marcorispoli/PCB325/DOC/Note Di Progetto.docx

# BUG/NOTE

+ Condensatori al tantalio in lista parti, footprint di condensatori in alluminio case-c;

+ Portare R27, R45,R63 da 3K3 a 4K7 per ottimizzare il range di misura.

# Power Supply

## Ingresso alimentazione

Il circuito di alimentazione in ingresso è un classico schema con filtro EMI e fusibile.

Il connettore di ingresso conduce anche i segnali relativi al Bus di comunicazione, (CAN BUS) con relativo filtraggio e protezione ESD.

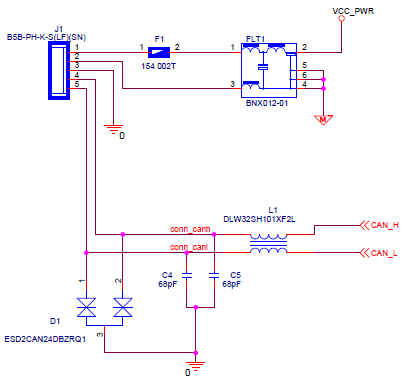
[picture p1: figure]

Il fusibile è impostato a 2A ritardato, sufficiente per il carico massimo richiesto all’alimentazione.

## Ingresso e circuito di hot swap

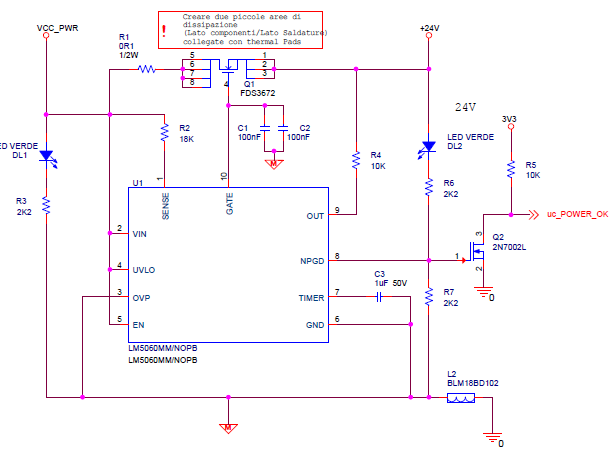
[picture p2: figure]

La tensione di alimentazione di ingresso a 24V viene protetta con un circuito di Hot-swap per consentire la connessione del dispositivo a “caldo”.

Il circuito Attiva l’alimentazione interna con una rampa di circa 300ms e fornisce un segnale di “tensione OK” al microcontrollore quando l’alimentazione è disponibile.

La massa “sporca” o massa motore viene qui unita alla massa di segnale, filtrata con una ferrite per ridurre le spurie condotte dalla sezione del microcontrollore.

### Verifica Circuito Hot-swap

All’accensione si osserva la tensione a +24V in uscita che cresce con una rampa di circa 200ms. Il valore atteso era di circa 300ms, cosa che successivamente potrà essere meglio indagata, ma è sufficiente per lo scopo inteso.

Il segnale uc_Power_OK viene correttamente attivato al termine della rampa.

## Regolatore +12V

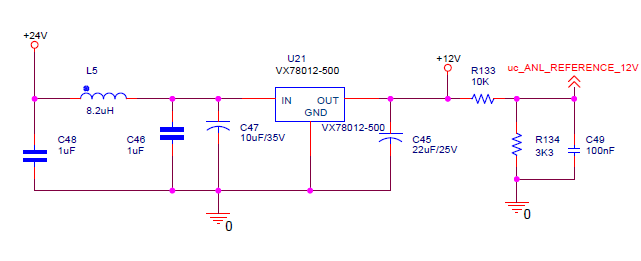
[picture p3: figure]

La scheda utilizza internamente la tensione +12V in diverse sezioni del circuito sia direttamente che come tensione intermedia.

Il regolatore utilizzato, un DC/DC switching, fornisce una tensione stabilizzata con 500mA di corrente massima.

Lo schema proposto è ricavato dal datasheet e sostanzialmente fa uso di una rete LC in ingresso per filtrare le spurie dello stadio switching verso l’alimentazione.

La tensione, opportunamente scalata, viene riletta dal microcontrollore sia come diagnostica sia per calibrare i segnali analogici che da essa dipendono.

### Verifica Circuito Regolatore +12V

La tensione misurata dopo il transitorio di accensione risulta: 12.08V;

Il segnale di controllo verso il microcontrollore risulta: uc_ANL_REFERENCE_12V: 2.98V;

Non sono presenti oscillazioni anomali o disturbi inattesi.

## Regolatore +5V + 3.3V

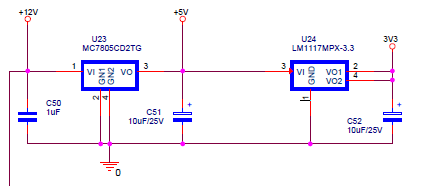
[picture p4: figure]

La scheda utilizza internamente per alimentare diverse parti circuitali una tensione stabilizzata di 5V ottenuta con un regolatore lineare a partire dalla +12V.

Per le alimentazioni e i circuiti di servizio del microcontrollore utilizza una 3.3V ricavata direttamente dalla tensione +5V.

### Verifica tensioni regolate

Tensione +5V: V = 5.048, Rp = 300mV;

Temperatura U23: circa 40°;

Tensione 3V3: V = 3.298, Rp = 90mV;

Temperatura U24: circa 30°;

## Regolatore +5V-EXT

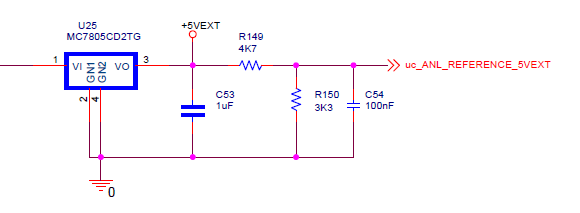
[picture p5: figure]

La scheda utilizza per alimentare parti di dispositivo esterne alla scheda un regolatore lineare da 5V uguale al regolatore per la +V interna.

A scopo diagnostico il valore viene riletto opportunamente scalato dal microcontrollore.

### Verifica Regolatore +5V-EXT

Tensione misurata: V = 5.048, Rp = 300mV;

Temperatura: circa 40°;

uc_ANL_REFERENCE_5VEXT = 2.067, Rp= 200mV

# Controllore

Lo schema utilizza un microcontrollore microchip della serie SAME51J20A.

Il microcontrollore non utilizza oscillatori /quarzi esterni per generare le frequenze di BUS interne.

Lo schema di alimentazione del microcontrollore è ricavato direttamente dal datasheet e fa uso di ferriti beads sulle sezioni di alimentazione per ridurre le EMI condotte.

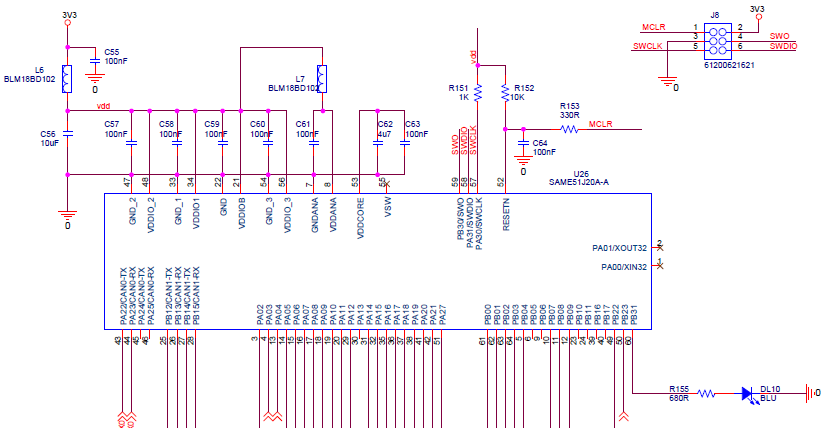
[picture p6: figure]

Il micro viene programmato tramite il connettore J6 con apposito protocollo e programmatore della serie PICKIT-xx compatibile con i controllori SAME.

Il controllore è dotato di LED blu con la funzione di Vitality Led.

## Verifica programmazione

Allo scopo di verificare il corretto funzionamento è stato preparato un firmware di test che permette di attivare il led di vitalità con un periodo di ON-OFF di 2 secondi (1 secondo ogni stato).

La programmazione è avvenuta con successo e la frequenza di oscillazione è quella attesa.

L’alimentazione è rimasta stabile.

Spegnendo e riaccedendo l’alimentazione di ingresso a 24V, il microcontrollore è ripartito correttamente.

# Circuito di controllo del Buzzer

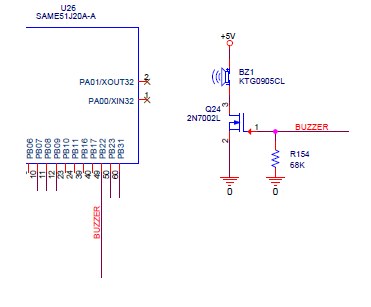
[picture p7: figure]

Il microcontrollore controlla direttamente un Buzzer collegato all’uscita PB22 tramite un Mosfet di segnale.

## Verifica Buzzer

Il firmware di test utilizzato ha generato delle attivazioni ON-OFF con 1 secondo di attivazione per stato.

Il Buzzer ha correttamente eseguito il ciclo di attivazione.

# Circuito di controllo alimentazione motore

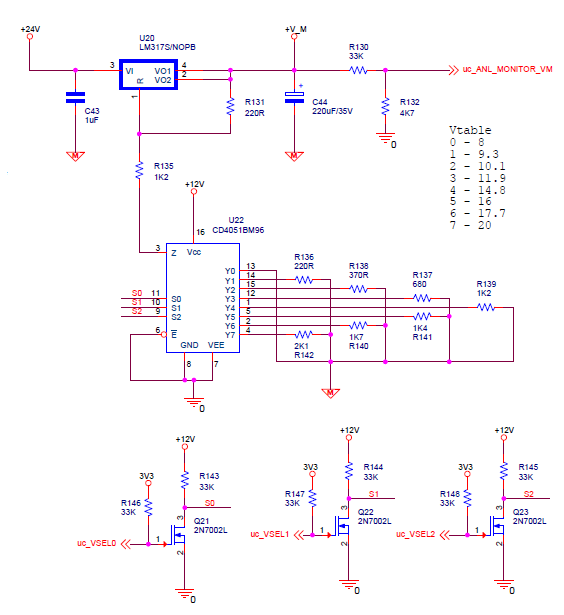
[picture p8: figure]

La scheda utilizza un regolatore lineare controllato digitalmente per generare livelli differenti di alimentazione per il driver motore. Questo consente di regolare la coppia disponibile e la velocità massima del motore durante le fasi di accelerazione corsa e avvicinamento al target di posizionamento.

Il regolatore è un classico LM317 il cui circuito di controllo viene gestito attraverso un CD4051 che assegna 8 possibili resistenze in serie a R135, ottenendo quindi 8 possibili livelli di regolazione della tensione di uscita.

## Verifica della selezione tensione motore

La tabella che segue mostra i livelli attesi in funzione dell’impostazione dei segnali digitali e il valore effettivamente generato dalla scheda:

Vsel2 | Vsel1 | Vsel0 | V - attesa | V - misurata
1 | 1 | 1 | 8 | 9.17
1 | 1 | 0 | 9.3 | 10.3
1 | 0 | 1 | 10.1 | 11.19
1 | 0 | 0 | 11.9 | ???
0 | 1 | 1 | 14.8 | 15.87
0 | 1 | 0 | 16 | 17.2
0 | 0 | 1 | 17.7 | 18.82
0 | 0 | 0 | 20 | 20.51

# Circuito di controllo dei pulsanti di attivazione

La funzione dei pulsanti di attivazione motori è duplice:

+ Attivazione motori per calibrazione posizioni: alla pressione dei pulsanti, i motori si muovono a target predefiniti;

+ Attivazione motori per piccoli steps: alla pressione dei pulsanti, i motori si muovono di piccoli steps predefiniti;

Il circuito di controllo dei pulsanti prevede:

+ una sezione di rilevazione del pulsante premuto che riporta al microcontrollore lo stato di attivazione;

+ una sezione di bypass delle sicurezze di attivazione del motore;

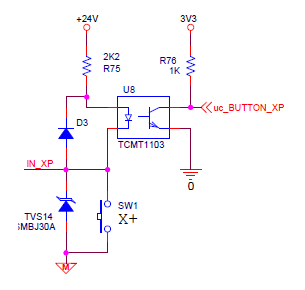
[picture p9: figure]

Per ogni pulsante di attivazione (in figura è riportato il pulsante X+) è prevista una protezione ESD e un opto isolatore. Lo stato di attivazione è attivo Basso.

### Verifica del rilevamento attivazione pulsante

La tabella che segue riporta lo stato delle tensioni rilevate in funzione della pressione del pulsante relativo:

Pulsante | Stato | V - micro
X+ | Off | 3.3
X+ | On | 0.13
X- | Off | 3.3
X- | On | 0.13
Y+ | Off | 3.3
Y+ | On | 0.13
Y- | Off | 3.3
Y- | On | 0.13
Z+ | Off | 3.3
Z+ | On | 0.13
Z- | Off | 3.3
Z- | On | 0.13

Con il firmware di test si è verificato che lo stato di ciascun pulsante sia correttamente letto dal microcontrollore. Il test è stato eseguito con successo.

# Sicurezza motore

Il circuito di sicurezza motore interdice l’attivazione dei motori aprendo con un relè allo stato solido uno dei segnali di pilotaggio dei motori stessi.

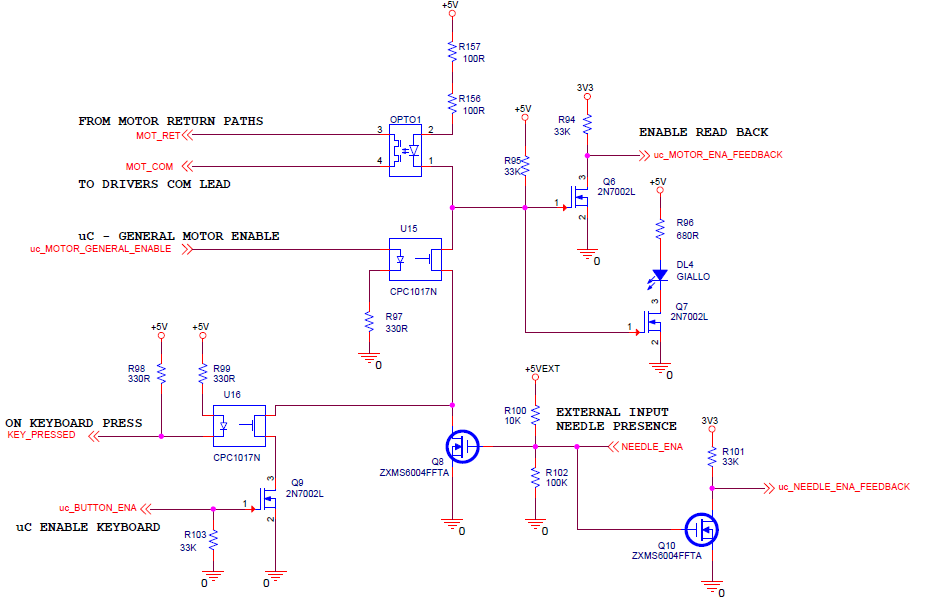
[picture p10: figure]

Nell’immagine precedente che rappresenta lo schema generale di controllo della sicurezza motori si identificano i seguenti segnali:

+ MOT_RET: è il segnale di ritorno dei motori;

+ MOT_COM: è il segnale di ritorno al driver motore;

+ uc_MOTOR_ENA_FEEDBACK: è il segnale (attivo alto) che indica al microcontrollore lo stato di attivazione del relè di sicurezza;

+ uc_MOTOR_GENERAL_ENABLE: è il segnale (attivo alto) di abilitazione generale del relè allo stato solido;

+ uc_BUTTON_ENA: è il segnale (attivo alto) di abilitazione del bypass da pulsanti manuali;

+ KEY_PRESSED: è il segnale (attivo basso) di pressione di almeno un pulsante manuale;

+ NEEDLE_ENA: è il segnale (attivo alto) di assenza del NEEDLE;

+ uc_NEEDLE_ENA_FEEDBACK : è il segnale (attivo alto) dello stato di assenza del needle per il microcontrollore;

Il led DL4 indica che la protezione è attiva (motore disabilitato)

## Abilitazione generale

Una linea digitale del microcontrollore (uc_MOTOR_GENERAL_ENABLE) ha la funzione di abilitazione generale: se tale linea è disattiva il relè è sempre aperto:

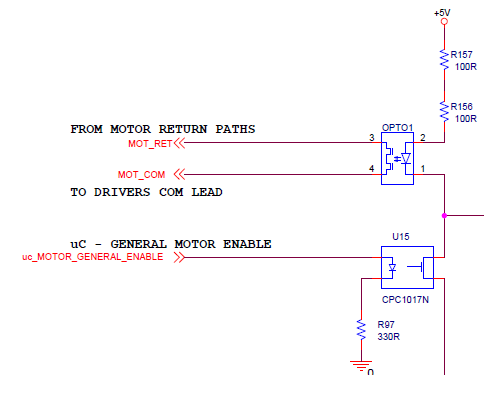
[picture p11: figure]

Come si vede dall’immagine precedente, se il segnale è spento il circuito di pilotaggio del relè viene interdetto.

## Abilitazione da Pulsanti manuali

La scheda deve consentire l’abilitazione all’attivazione dei motori se uno dei pulsanti viene premuto.

La scheda utilizza anche una linea digitale del microcontrollore per abilitare questa funzione.

Quando l’abilitazione è attiva e uno dei pulsanti viene premuto, il relè allo stato solido si attiva.

Come si osserva dalla figura seguente, la linea marrone indica il percorso circuitale di attivazione del relè allo stato solido:

- Abilitazione Generale ((uc_MOTOR_GENERAL_ENABLE);
- KEY_PRESSED = 0.7V;
- Abilitazione bypass da pulsanti (uc_BUTTON_ENA);

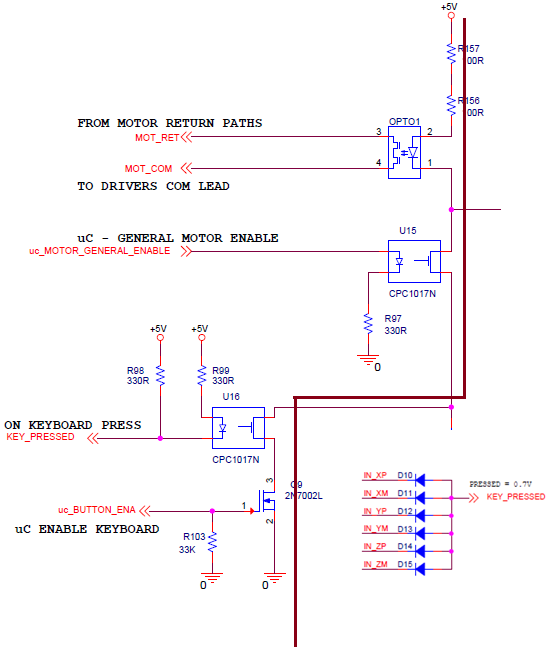
[picture p12: figure]

## Abilitazione da assenza NEEDLE (NEEDLE_ENA)

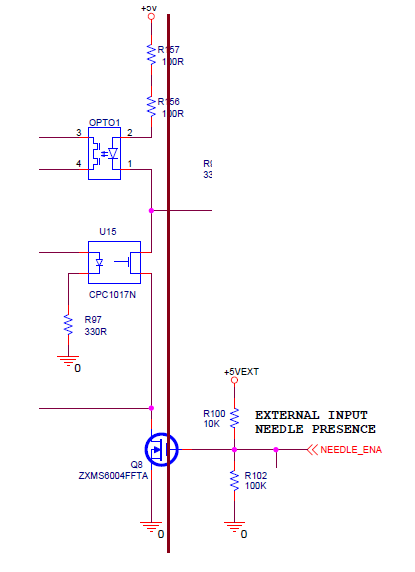
[picture p13: figure]

Come si può osservare dall’immagine precedente, se il segnale proveniente dal sensore di presenza NEEDLE dovesse essere cortocircuitato a massa (needle presente), il mosfet Q8 si apre aprendo anche il relè di sicurezza (si intende senza che i pulsanti manuali siano attivi).

Se invece il needle non è presente (segnale aperto) oppure l’asse Y disconnesso, allora il mosfet chiude il circuito di pilotaggio del relè che risulterà pertanto chiuso (abilitando quindi l’attivazione dei motori).

## Verifica circuiti di sicurezza

### Verifica segnale di abilitazione generale

+ Verificato segnale uc_MOTOR_GENERAL_ENABLE coon micocontrollore;

### Verifica segnale NEEDLE_ENA e feedback

+ Contatto ZIF con Q8 = OK;

+ con NEEDLE_ENA aperto, tensione sulla base di Q8 = 3.3V corretta.

- NOTA: Q8 e Q10 hanno insieme una resistenza di gate (parallelo tra le due) pari a 14K. La tensione di soglia è al massimo 1.5V quindi la polarizzazione a vuoto è sufficiente. Quando l’asse Y è connesso, una resistenza di pullup di 1K aumenterà ulteriormente il livello di polarizzazione.

+ Circuito di Feedback microcontroller OK;

Sebbene la tensione su Q8 sia anomala, tutttavia il circuito funziona.

### Verifica bypass da pulsanti manuali

+ KEY_PRESSED: controllato con tutti i pulsanti, passa da +5V a 0.7V come atteso.

+ uc_BUTTON_ENA: testato con attivazione da microcontrollore;

### Verifica Tabella di Attivazione

General Enable | Key Enable | Key Pressed | NEEDLE_ENA | Power Switch | Motor Ena Feedback | DL4 | Verify
ON | ON | ON/OFF | GND | ON/OFF | ON/OFF | OFF/ON | OK
X | OFF | X | GND | OFF | OFF | ON | OK
OFF | X | X | X | OFF | OFF | ON | OK
ON | X | X | HZ | ON | ON | OFF | OK

# Drivers Motori

La scheda utilizza due drivers per controllare 3 motori brush con schema a doppio ponte H in parallelo.

Ciascun driver è caratterizzato dai seguenti segnali di controllo:

+ ENABLE-A: segnale di abilitazione canale A del driver. Se disabilitato il canale mette le uscite in alta impedenza;

+ ENABLE-B: segnale di abilitazione canale B del driver. Se disabilitato il canale mette le uscite in alta impedenza;

+In1-A, In2-A: imposta la modalità del ponte (direzione) per il canale A;

+In1-B, In2-B: imposta la modalità del ponte (direzione) per il canale B;

Il driver viene alimentato con la +V-M che assume valori da 10 a 20V in funzione della codifica digitale che il microcontrollore fornisce al regolatore.

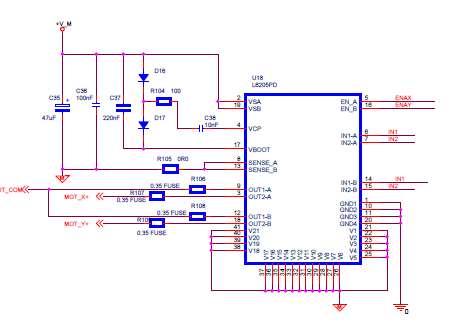
[picture p14: figure]

Le uscite sono tutte protette da PTC che limitano correnti di CC.

La codifica dei segnali di controllo viene ottenuta attraverso un decoder digitale:

i mosfet servono per adattare i segnali digitali del microcontrollore a 3.3V con quelli dei drivers a 5V.

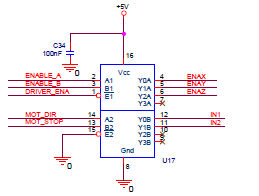
[picture p15: figure]
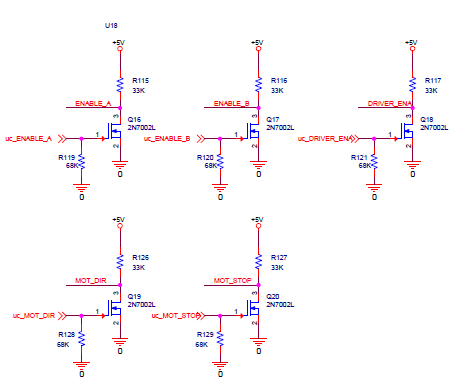
[picture p16: figure]

Tabella di abilitazione driver motore

uc_DRIVER_ENA | uc_ENABLE_B | uc_ENABLE_A | MOTOR-X-ENA (DL5) | MOTOR-Y-ENA (DL6) | MOTOR-Z-ENA (DL7)
0 | X | X | 0 (OFF) | 0 (OFF) | 0 (OFF)
1 | 0 | 0 | 0 (OFF) | 0 (OFF) | 0 (OFF)
1 | 0 | 1 | 0 (OFF) | 0 (OFF) | 1 (ON)
1 | 1 | 0 | 0 (OFF) | 1 (ON) | 0 (OFF)
1 | 1 | 1 | 1 (ON) | 0 (OFF) | 0 (OFF)

uc_MOTOR_STOP | uc_MOTOR_DIR | In1 (DL8) | In2 (DL9) | Motor Output state
0 | 0 | 0 | 0 | SHORT-GND
0 | 1 | 0 | 0 | SHORT-GND
1 | 0 | 0 | 1 | GND - VM
1 | 1 | 1 | 0 | VM – GND

## Verifica Drivers Motori

### Verifica abilitazione motori

Con un firmware di test vengono stimolati i segnali di controllo.

Con il tester vengono misurate le tensioni sui pin di controllo del driver e l’effettivo stato di attivazione dei leds:

uc_DRIVER_ENA | uc_ENABLE_B | uc_ENABLE_A | V DRIVER-ENA | V ENABLE-B | V ENABLE-A
1 | - | - | 0 | 4.8 | 4.8
- | 1 | - | 4.8 | 0 | 4.8
- | - | 1 | 4.8 | 4.8 | 0

uc_DRIVER_ENA | uc_ENABLE_B | uc_ENABLE_A | V ENAX (DL5) | V ENAY (DL6) | V ENAZ (DL7)
0 | X | X | 0 (OFF) | 0 (OFF) | 0 (OFF)
1 | 0 | 0 | 0 (OFF) | 0 (OFF) | 0 (OFF)
1 | 0 | 1 | 0 (OFF) | 0 (OFF) | 5V (ON)
1 | 1 | 0 | 0 (OFF) | 5V (ON) | 0 (OFF)
1 | 1 | 1 | 5V (ON) | 0 (OFF) | 0 (OFF)

### Verifica tabella attivazione motori

Con un firmware di test vengono stimolati i segnali di controllo.

Con il tester vengono misurate le tensioni sui pin di controllo del driver e l’effettivo stato di attivazione dei leds:

uc_MOT_STOP | uc_MOT_DIR | V MOTOR-STOP | V MOTOR-DIR
1 | - | 0 | 4.8
- | 1 | 4.8 | 0

uc_MOT_STOP | uc_MOT_DIR | V-IN1 (DL8) | V-IN2 (DL9)
0 | 0 | 0 (OFF) | 0 (OFF)
0 | 1 | 0 (OFF) | 0 (OFF)
1 | 0 | 0 (OFF) | 5 (ON)
1 | 1 | 5 (ON) | 0 (OFF)

### Verifica uscite motori

Con firmware di test si imposta la scheda come segue:

- Tensione dell’alimentazione motore pari a circa 10V;
- Abilitazione generale attivazione motori;
- Segnale NEEDLE_ENA aperto;

Disabilitazione di tutti i motori:

- uc_DRIVER_ENA = OFF;

verificare che tutte le uscite motori siano in alta impedenza;

Abilitazione motori e verifica uscite:

- uc_DRIVER_ENA = ON;

Motor X

uc_ENABLE_B | uc_ENABLE_A | uc_MOTOR_STOP | uc_MOTOR_DIR | X+ | X-COM
1 | 1 | 0 | X | GND | GND
1 | 1 | 1 | 0 | GND | VM
1 | 1 | 1 | 1 | VM | GND

Motor Y

uc_ENABLE_B | uc_ENABLE_A | uc_MOTOR_STOP | uc_MOTOR_DIR | Y+ | Y-COM
1 | 0 | 0 | X | GND | GND
1 | 0 | 1 | 0 | GND | VM
1 | 0 | 1 | | VM | GND

Motor Z

uc_ENABLE_B | uc_ENABLE_A | uc_MOTOR_STOP | uc_MOTOR_DIR | Y+ | Y-COM
0 | 1 | 0 | X | GND | GND
0 | 1 | 1 | 0 | GND | VM
0 | 1 | 1 | | VM | GND

# Power LED

La scheda controlla un Led di potenza con circuito switching che regola la corrente erogata al led ad esso connesso:

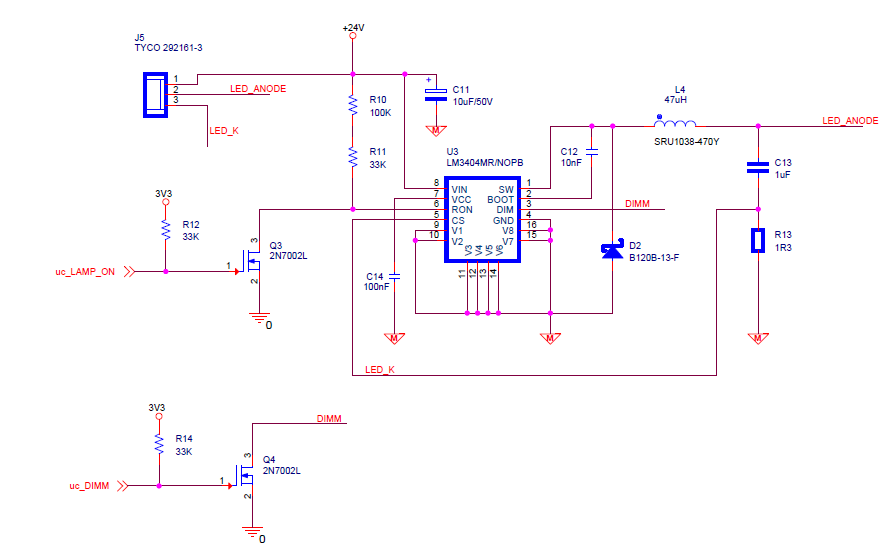
[picture p17: figure]

Il circuito prevede i seguenti segnali di controllo:

- uc_LAMP_ON: attivo basso, abilita l’attivazione della LED;
- uc_DIMM: controlla in PWM la corrente di uscita del led;

uc_LAMP_ON | uc_DIMM | LUCE
1 | X | OFF
X | 1 | OFF
0 | 0 | 100% ON
0 | 1 | 0% ON

La corrente RMS sul led attesa è circa di 200mA quando DIMM è pilotato al 100%.

## Verifica funzionamento e prestazioni

La massima corrente misurata con DIMM = 0 (100%) risulta pari a 190mA;

Con il firmware di test si realizza un PWM che con un periodo di 3.8ms imposta il segnale uc_DIMM con un duty cycle da 0 a 100%: la corrente misurata passa da pochi mA alla massima corrente seguendo l’andamento del segnale uc_DIMM.

# Posizione Assi X,Y,Z

La gestione della posizione per ogni asse avviene secondo lo schema della figura seguente:

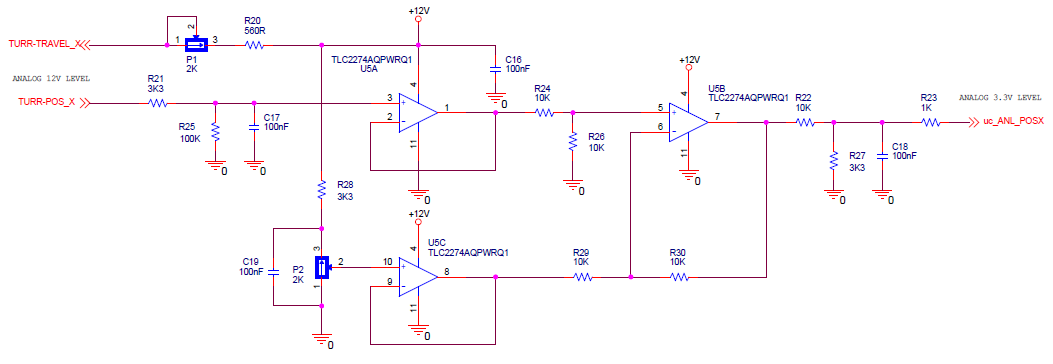
[picture p18: figure]

La dinamica della corsa viene regolata con il potenziometro P1 da 2K che limita il massimo valore di tensione sul potenziometro da 5K usato per rilevare la posizione.

La posizione di zero viene impostata con il potenziometro P2 la cui tensione viene detratta dalla tensione di ingresso del potenziometro di misura.

La formula per ottenere il valore di tensione in uscita è la seguente:

Vout = (((12 * 5 * psens / (5 + p1*2 + 0.56)) * 0.968 ) – p2 * 12 * 2 / 5.3) * 0.248;

Nota: 0.248 è ottenuto con a partizione in uscita 3K3 su 10K. Questa non è ottimale poichè al massimo si ottiene una tensione di 2.54V invece che 3.3.

Meglio portare a 4k7 la resistenza bassa.

## Verifica Posizione

Le misure seguenti sono ottenute con 3K3.

Impostando Ps=1, P1=0,P2=0 si dovrebbe avere 2.54 (valore massimo ottenibile). Misurato 2.54 ;

Modificando i sensori l’uscita cambia in maniera attesa.

# RICONOSCIMENO ANALOGICO NEEDLE_ID

Il riconoscimento del tipo di Ago avviene tramite segnale analogico ottenuto come partitore tra una resistenza di 5K e una resistenza “remota” secondo lo schema seguente:

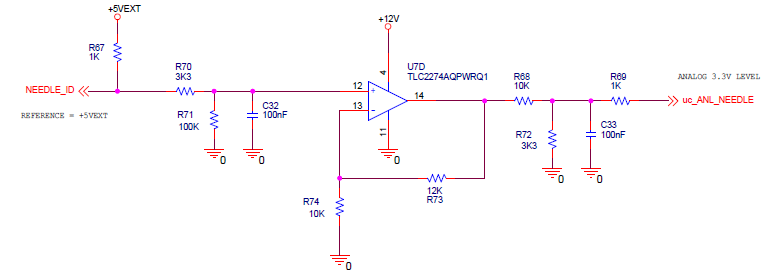
[picture p19: figure]

Fattore di conversione teorico: 0.5233;

## Verifica e performance

Valore di tensione V(uc_ANL_NEEDLE) con NEEDLE_ID aperto: 2.74V (atteso = 2.616);

Valore letto con Vin = 2.61V (resistenza circa 1K): 1.44V

# RICONOSCIMENO ANALOGICO XSCROLL

Il riconoscimento della traslazione dell’asse X avviene tramite segnale analogico ottenuto come partitore tra resistenze remote su alimentazione 5VEXT.

Il segnale viene bufferizzato, filtrato e convertito su range 3.3V

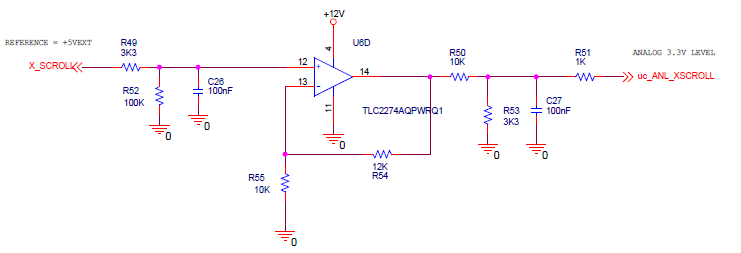
[picture p20: figure]

Fattore di conversione teorico: 0.528;

## Verifica e performance

…

# RICONOSCIMENO POSIZIONE SCIVOLO

Il riconoscimento della posizione dello scivolo sul cuneo viene ottenuto come partizione della tensione 12V (TURR-TRACEL_SH) e un potenziometro da 5K lineare.

Il segnale viene bufferizzato, filtrato e convertito in range 0-3.3V

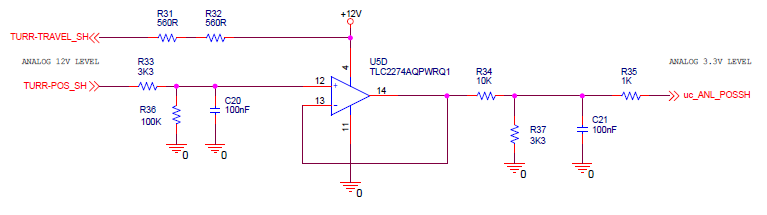
[picture p21: figure]

Formula di conversione:

Vout = 12 * (10 * psh / (10 *psh + 1.12)) * (100 /103.3) * (3.3/13.3);

con psh = [0:1];

## Verifica e performance

…
