marcorispoli/PCB325/DOC/PD 7.3.a A2 Mod 154_Z190_punto 4.9.2_PCB-23-325-0.pdf

All. 2 MODULO VERBALE Riunione di Progetto | PD 7.3.a A2
Procedura Documentata | Mod 154 | Rev. 1
“PROGETTAZIONE E SVILUPPO” | Pag. 1/ 1
PD 7.3.a A2 Mod 154_Z190_punto 4.9.5 | Pagina 1 di 1

Documento di proprietà privata - Riproduzione vietata

No. PROGETTO
001 / 2018

No. COMMESSA Z190

NOME APPARATO

Top of The Line DBT
DiMoBIS

VERIFICA
DELLA PROGETTAZIONE
(VERIFICA DEGLI ARTEFATTI)

### 4.9.2 Verifica degli artefatti elettronici - Verification of electronic artifacts

VERIFICA PROGETTO SCHEDA PCB\23-325-0
PCB\23-325-0 VERIFICATION

Introduzione.
Come da procedura le parti elettroniche dell’apparecchio sono soggette a verifica. Il presente verbale documenta la verifica sul prototipo della scheda PCB\23-325-0.

Il report è disponibile nell’allegato TRP0XX_00-Z190 PCB\23-325-0 Verification.

L’esito è POSITIVO.

As per procedure, the electronic parts of the appliance are subject to verification. This report documents the verification of the prototype PCB 23-325-0.

The report is available in the TRP0XX_00-Z190 PCB\23-325-0 Verification annex.

The result is POSITIVE.

Allegati /Attachment:

### 1. TRP018_00-Z190 PCB\23-325-0 VERIFICATION 2. CPV verification PCB\23-325-0-electronics_r00

Pomezia, 20.10.2024
FUNZIONI | NOMI PARTECIPANTI | FIRMA
hdR&D | Giovanni B. Peretta
hdPROMA | Federico Rinaldi
hdUFTEC | Gloria Pesce Delfino
rePROGEL | Marco Rispoli
