marcorispoli/PCB325/LAYOUT/Layout farcito.png

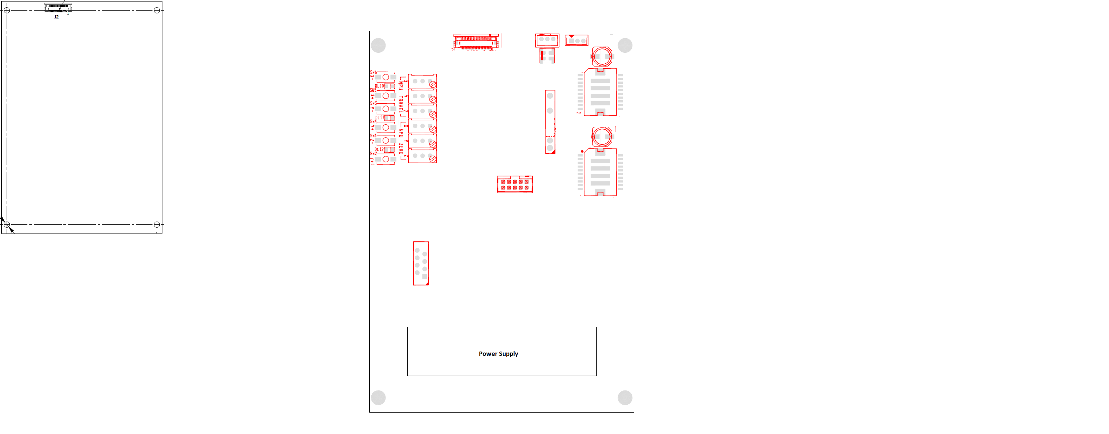
LAYOUT/Layout farcito.png
