marcorispoli/PCB325/(list of files, cad)

Other CAD files:
ESECUTIVI/PF23-325-0.dwg
LAYOUT/A0724-001-A - PCB-23-325-0 - SCHEDA CONTROLLER BIOPSIA LATERALE 1.DXF
ESECUTIVI/PM23-325-0.dwg
LAYOUT/23-325-0.dwg
ESECUTIVI/23-325-0.dwg
