marcorispoli/PCB325/DOC/CPV Check piano di verifica _r00.pdf

Procedura Documentata | PD 7.3-a
“PROGETTAZIONE E SVILUPPO”
Check piano di verifica | CPV Rev. 00

DISPOSITIVO MEDICO: Z190 - DiMoBIS (CYBELE) pCB/23-325-0

ASSEGNAZIONE NUMERO DI PROGETTO: 001 / 2018

TIPO DI VERIFICA | Descrizione funzionale oppure requisito (Rif. Allegato) | Descrizione metodo (Rif. Allegato) | ESITO POSITIVO | ESITO NEGATIVO
Elettronica x Meccanica □ Firmware □ Software □ | TRP0XX_00-Z190 PCB\23-325-0 VERIFICATION | TRP018_00-Z190 PCB\23-325-0 VERIFICATION | V

Elettronica □ Meccanica □ Firmware □ Software □

Elettronica □ Meccanica □ Firmware □ Software □

Elettronica □ Meccanica □ Firmware □ Software □

Elettronica □ Meccanica □ Firmware □ Software □

Elettronica □ Meccanica □ Firmware □ Software □

Elettronica □ Meccanica □ Firmware □ Software □

Firma e data del personale che ha effettuato la verifica: | Firma e data hdRD:

Marco Rispoli Giovanni Battista Peretta Gloria Pesce Delfino
