marcorispoli/PCB325/ORCAD/CONNESSIONI-DB9.pdf

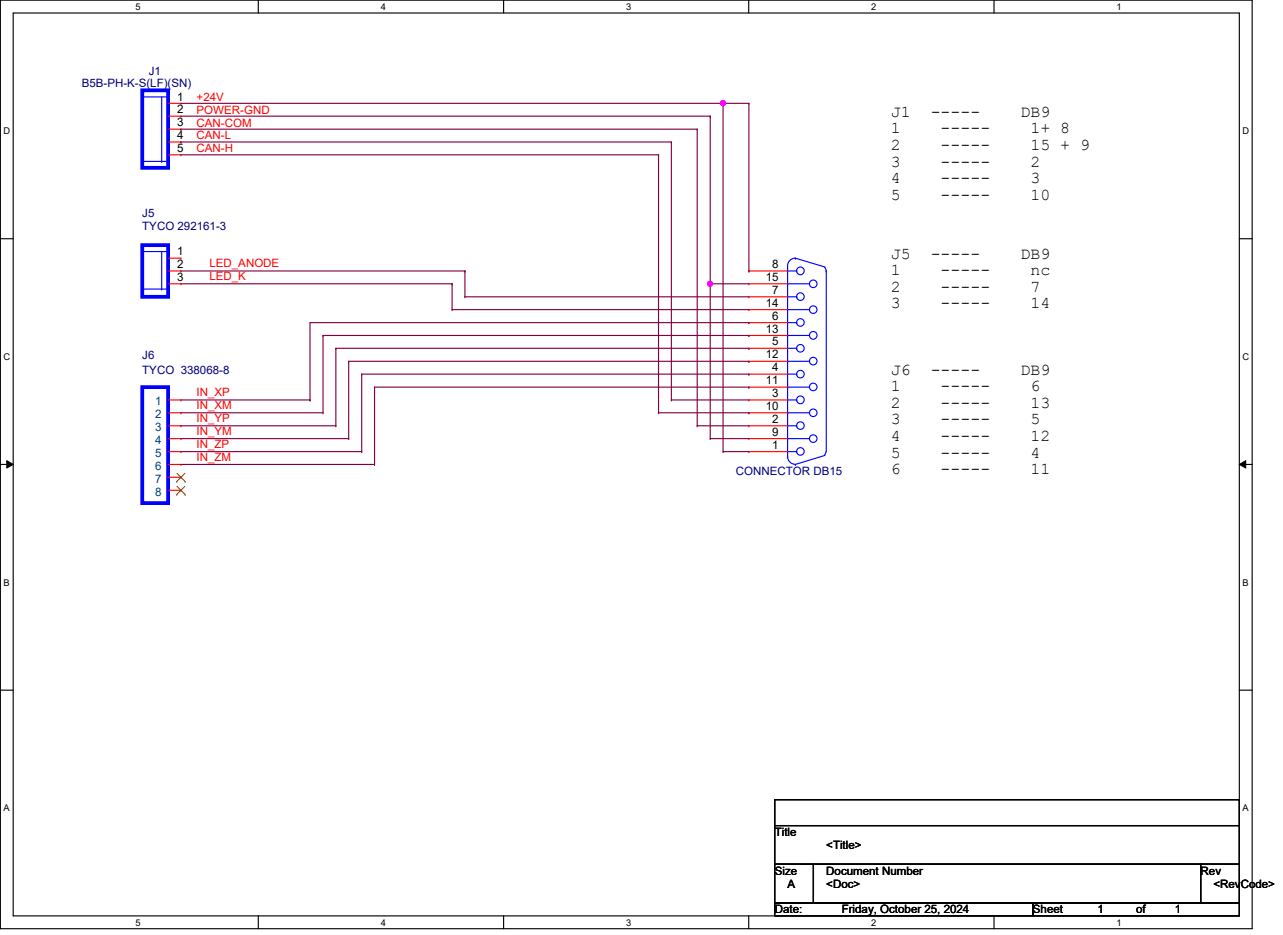
[picture p23: page 1]
Title; Size; Document Number; Rev; Date:; Sheet; <Doc>; <RevCode>; <Title>; 1 1Friday, October 25, 2024; J5 TYCO 292161-3; J6 TYCO 338068-8; CONNECTOR DB15; +24V POWER-GND CAN-COM CAN-L CAN-H; LED_ANODE LED_K
