marcorispoli/PCB325/ORCAD/SE23-325-0.pdf

0
0

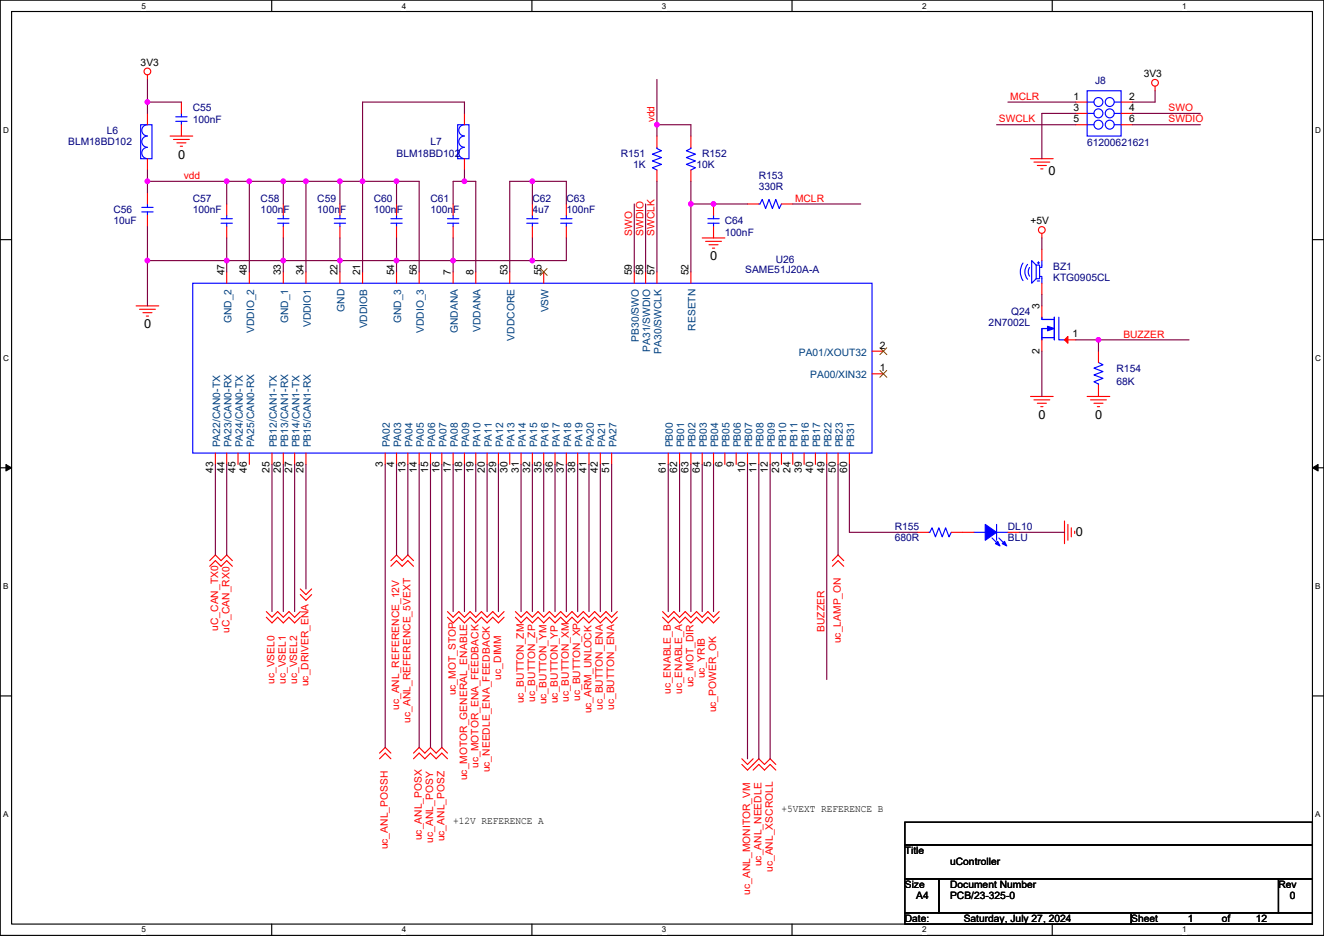
[picture p24: page 1]

Size A4 | Document Number PCB/23-325-0 | Rev 0

Date: Saturday, July 27, 2024 | Sheet 1 of 12

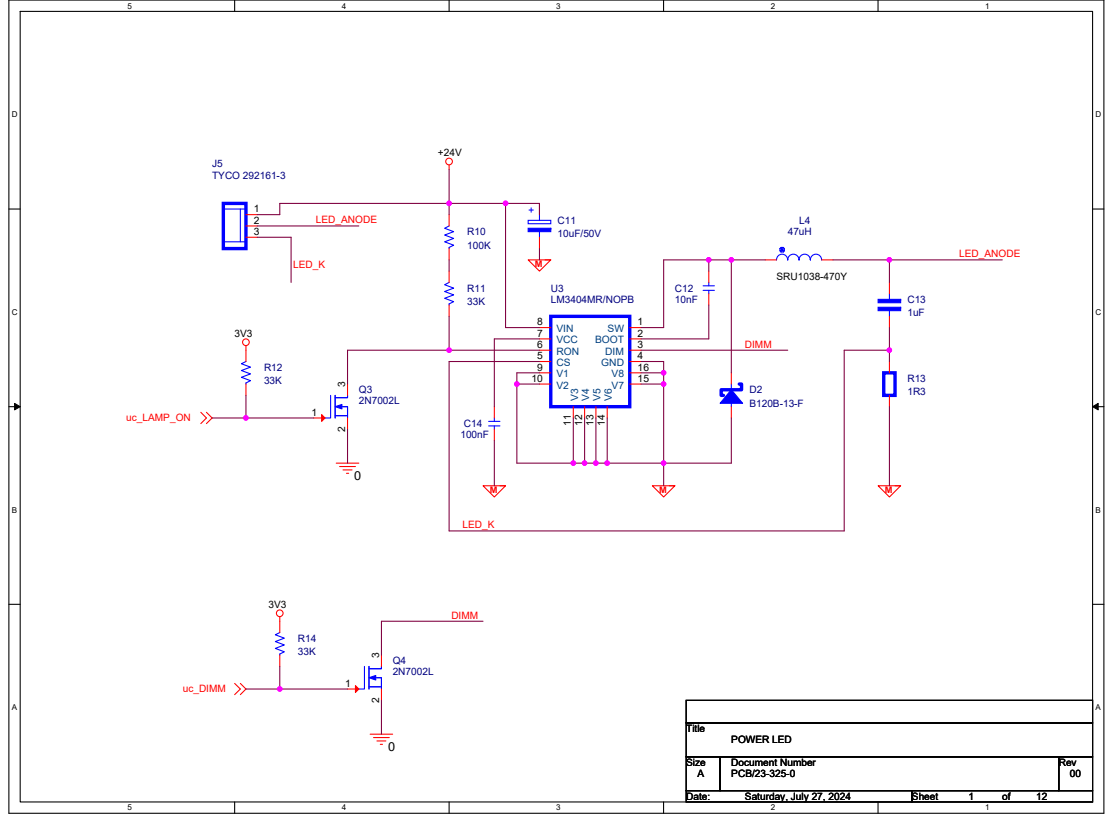
[picture p25: page 2]

## Vtable

0 - 8

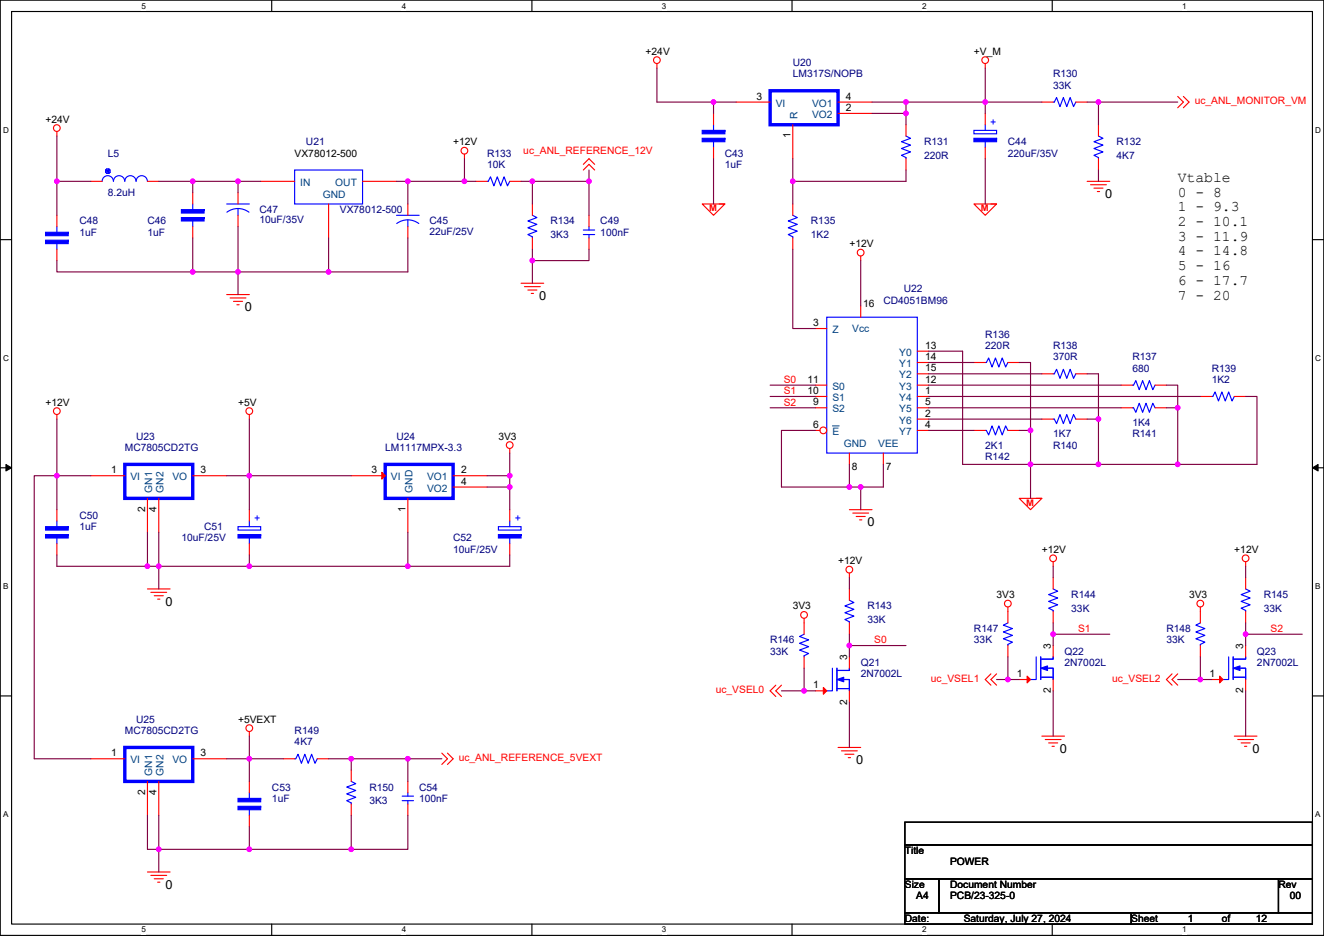
[picture p26: page 3]

0

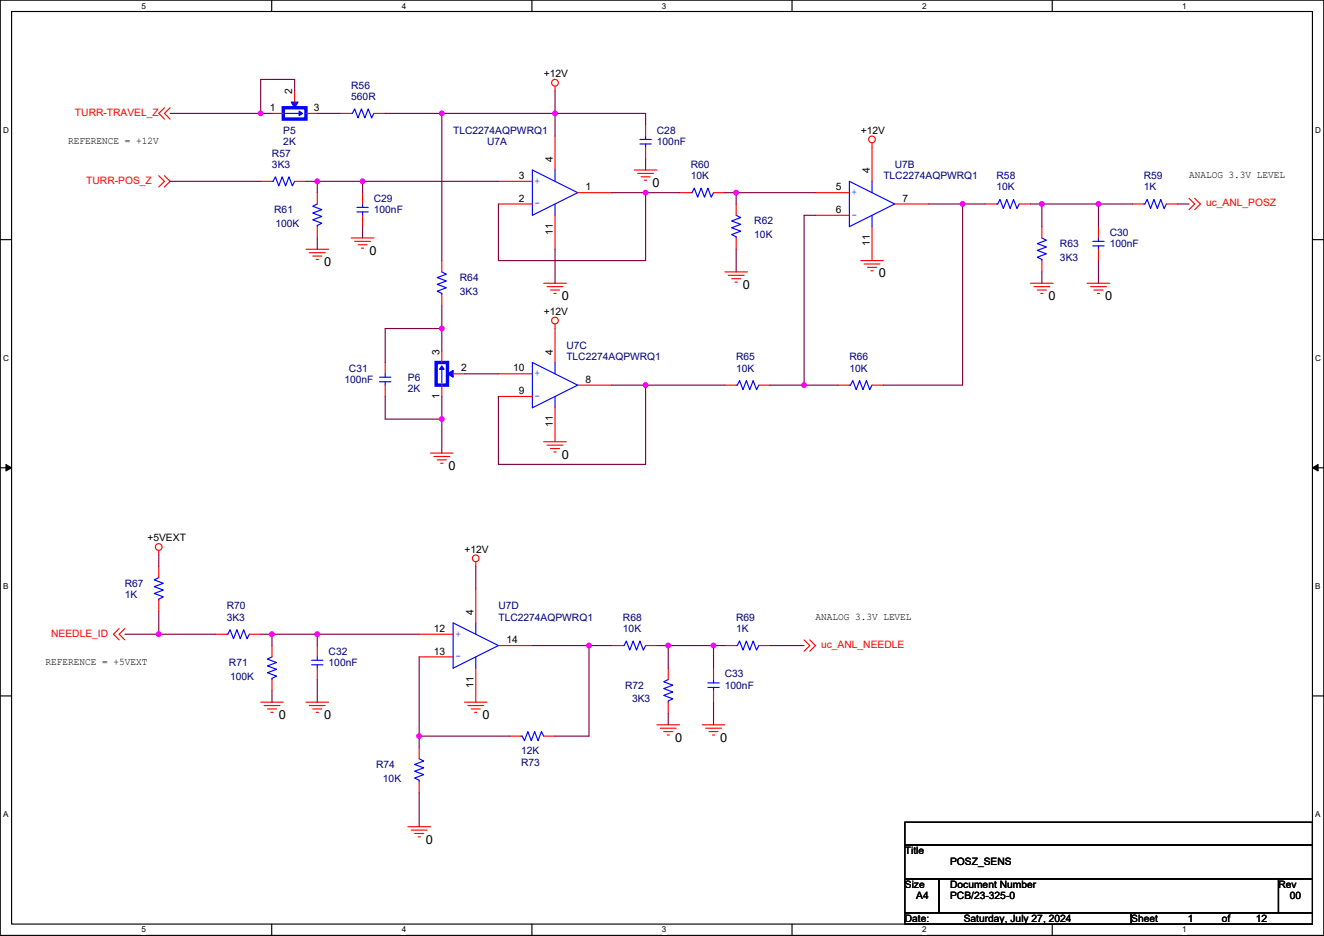
[picture p27: page 4]

0

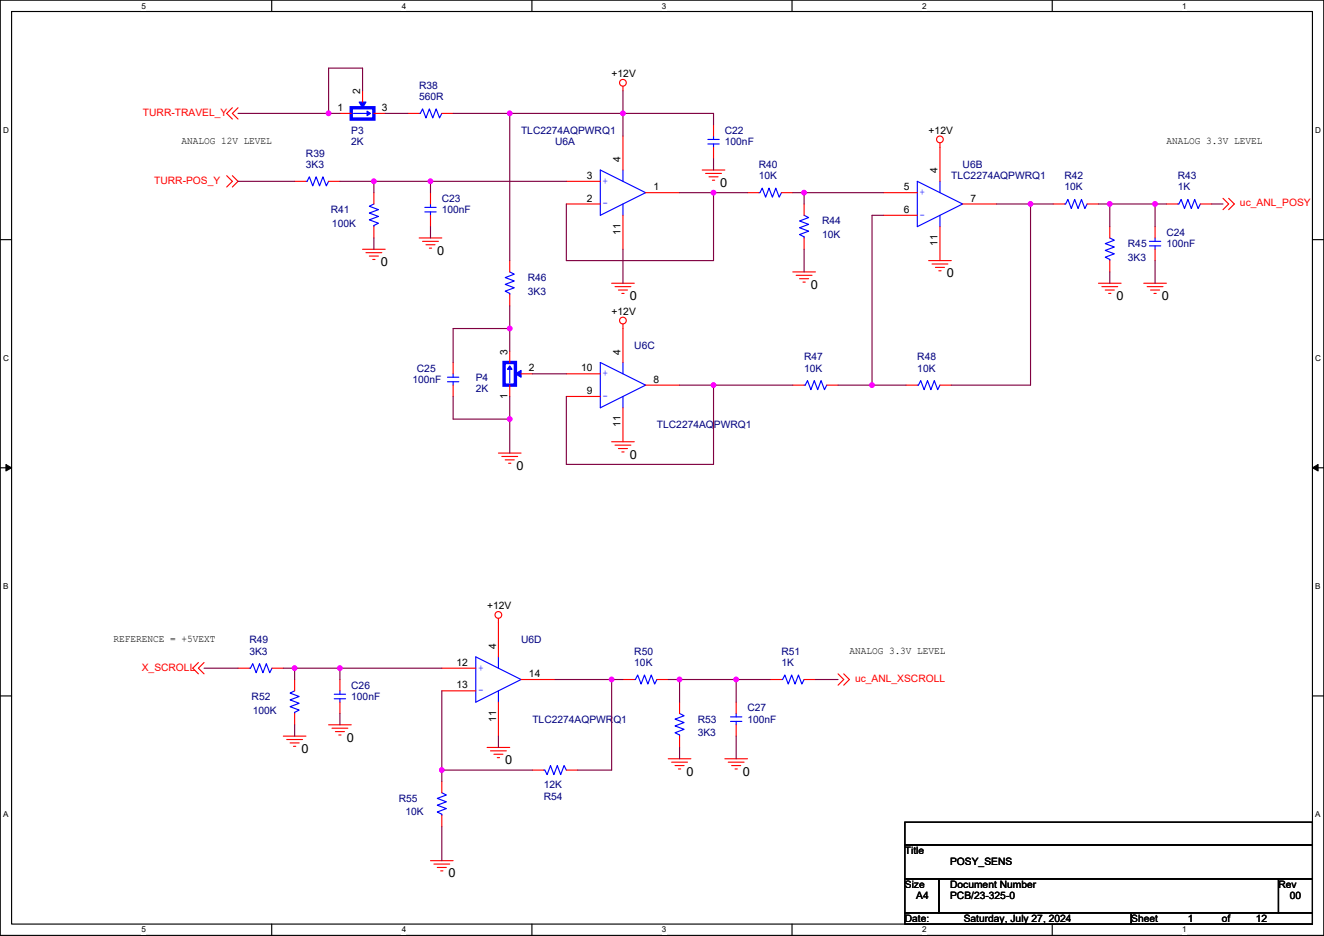
[picture p28: page 5]

0

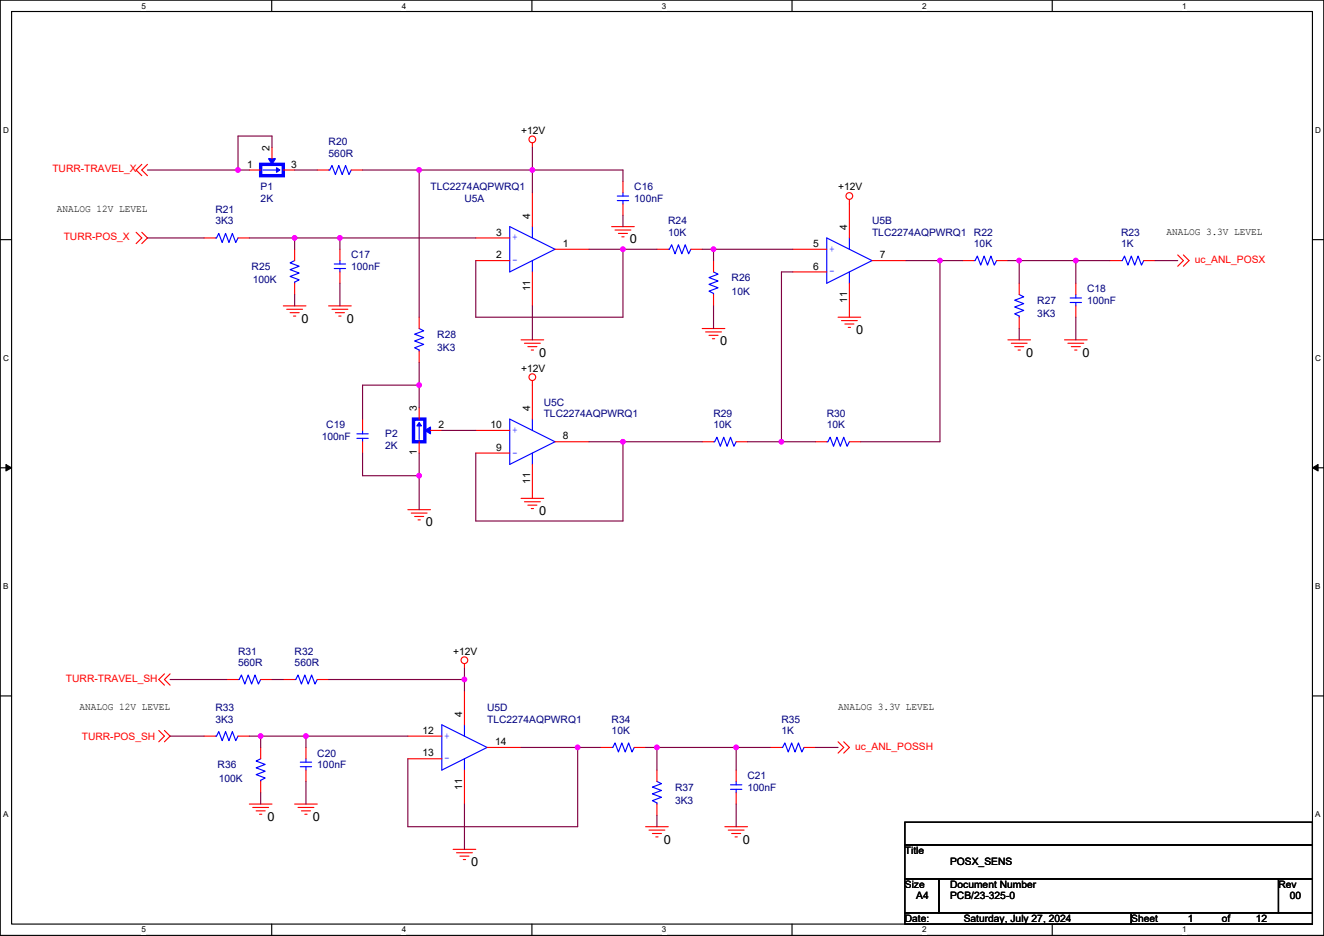
[picture p29: page 6]

0

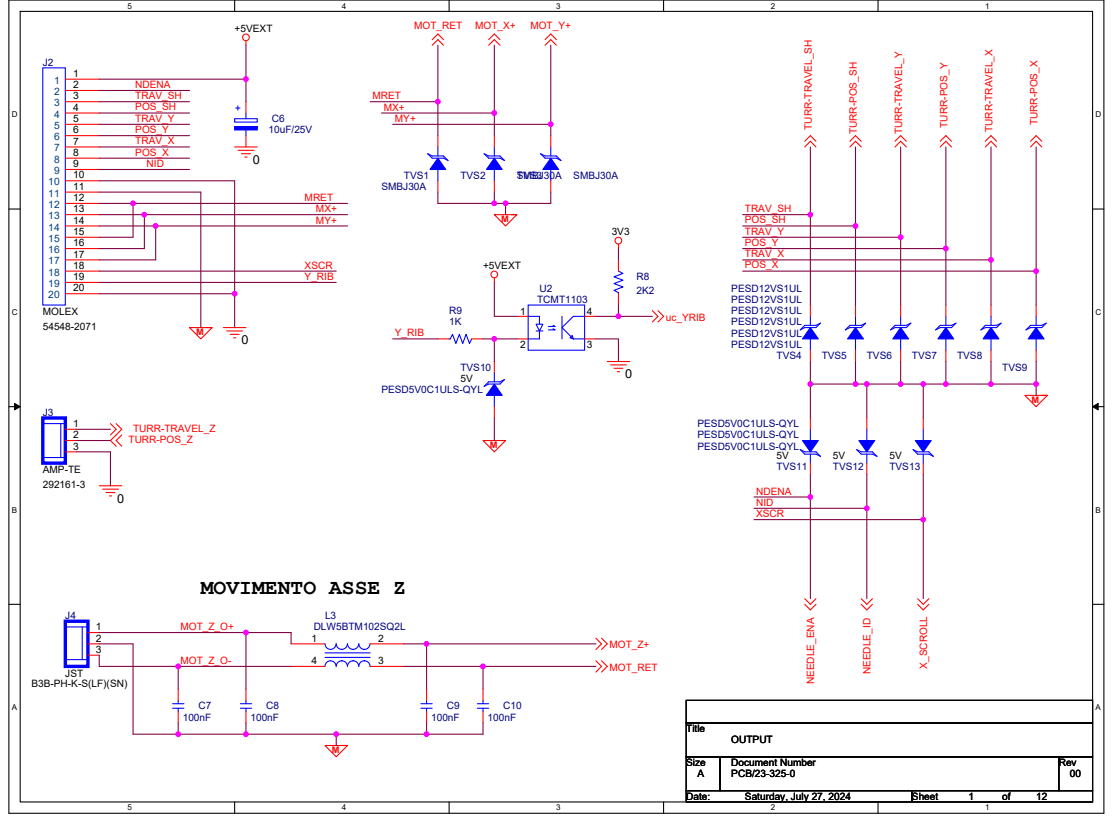
[picture p30: page 7]

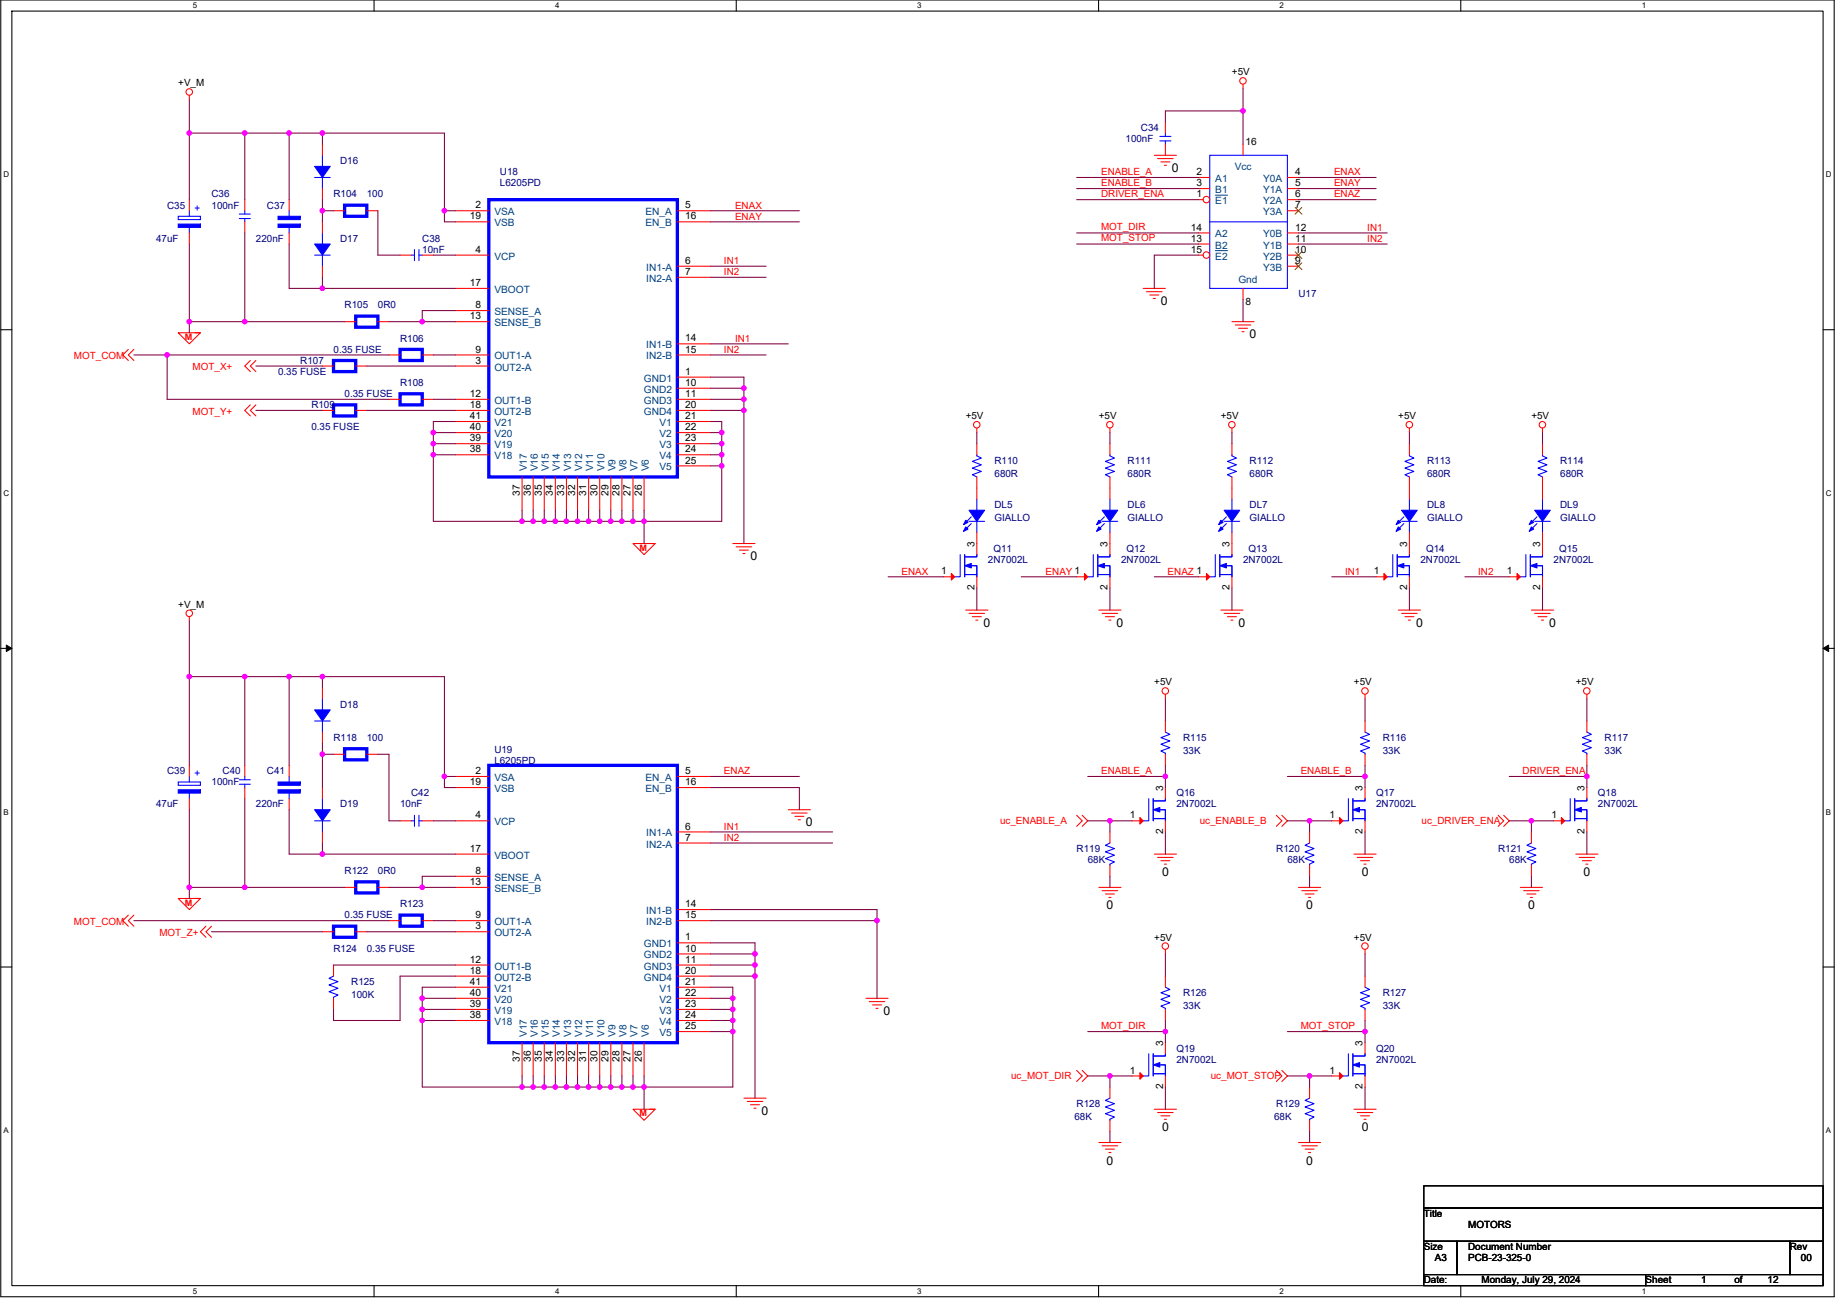
[picture p31: page 8]

PCB-23-325-0 PCB-23-325-0 PCB-23-325-0 | 00 00 00

Monday, July 29, 2024 Monday, July 29, 2024 Monday, July 29, 2024 | 1 1 1 12 12 12

# ENABLE READ BACK

# FROM MOTOR RETURN PATHS

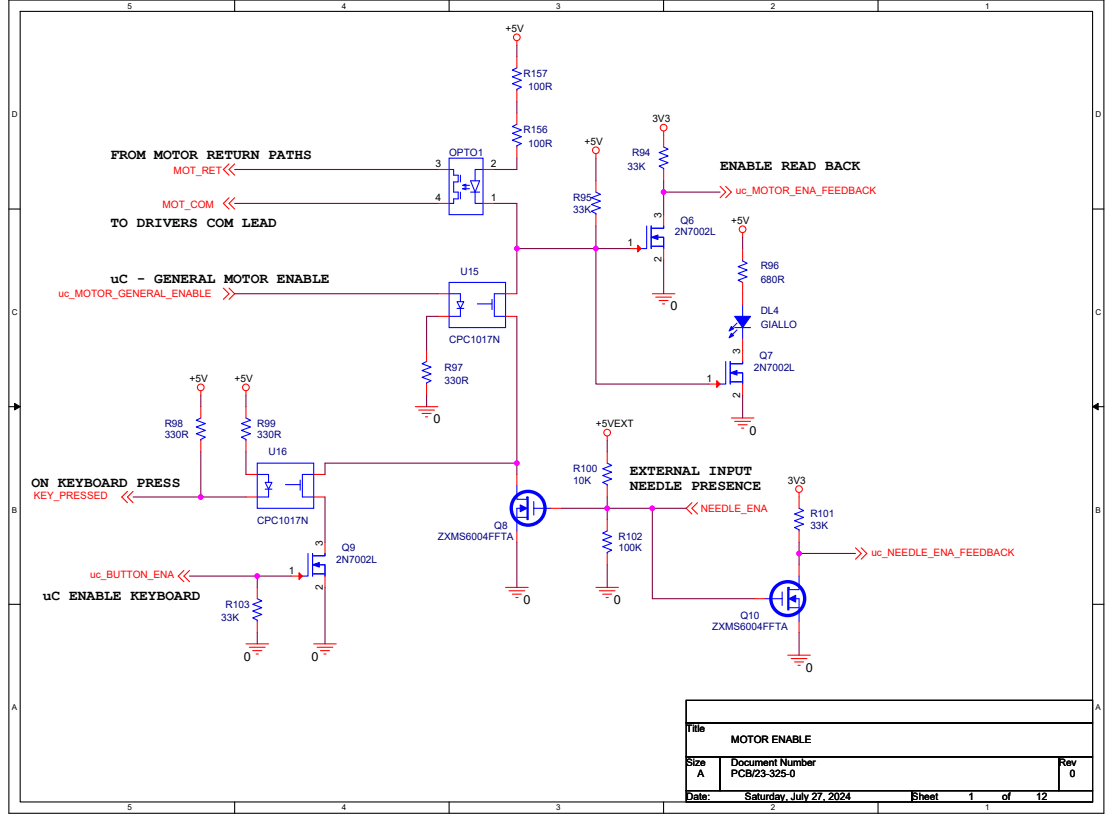
[picture p32: page 9]

TO DRIVERS COM LEAD

uC - GENERAL MOTOR ENABLE

5 | 4 | 3 | 2 | 1

D

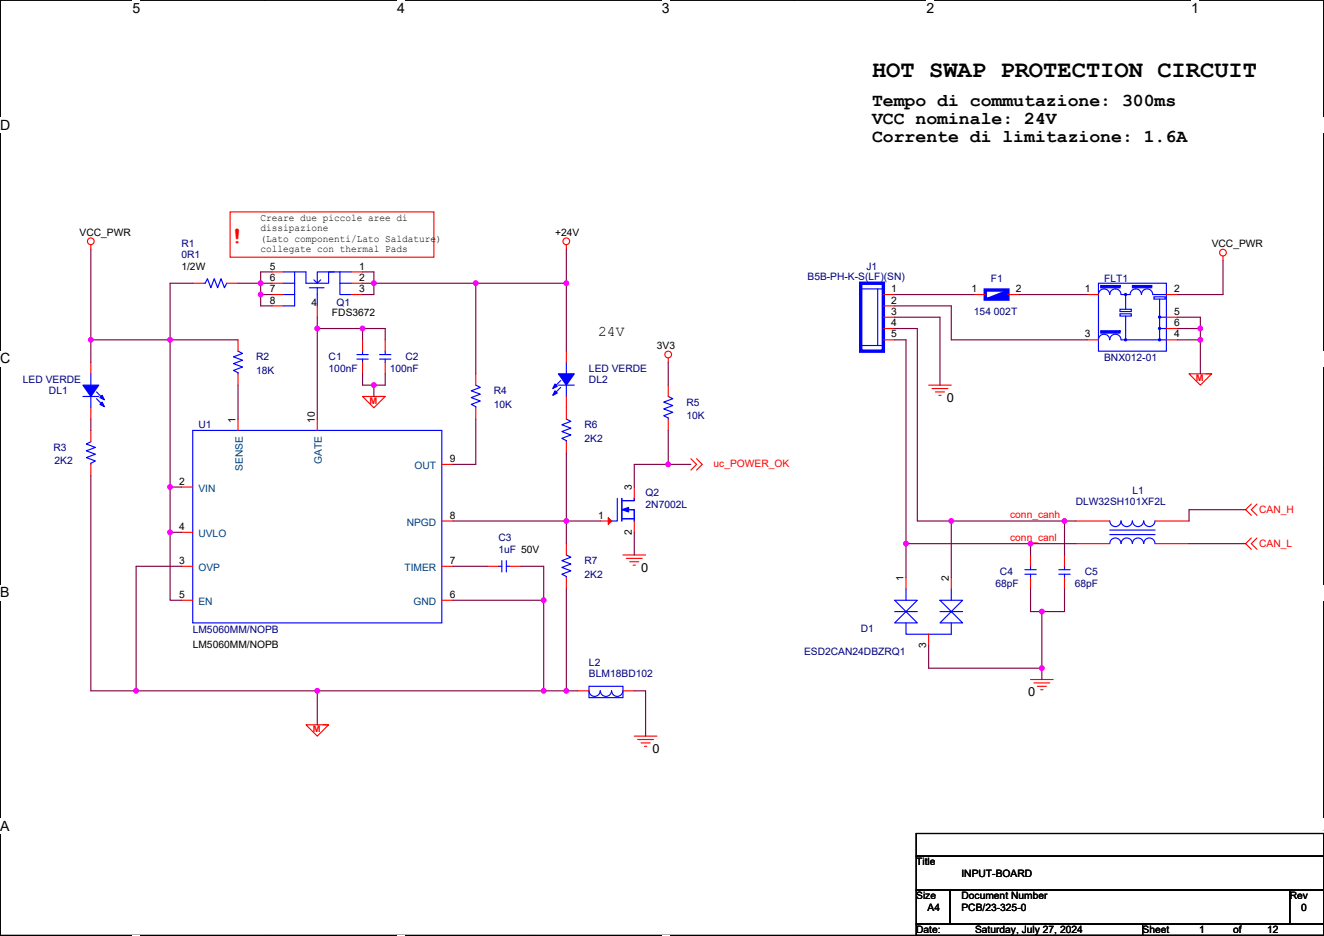
[picture p33: page 10]

HOT SWAP PROTECTION CIRCUIT
Tempo di commutazione: 300ms
VCC nominale: 24V
Corrente di limitazione: 1.6A

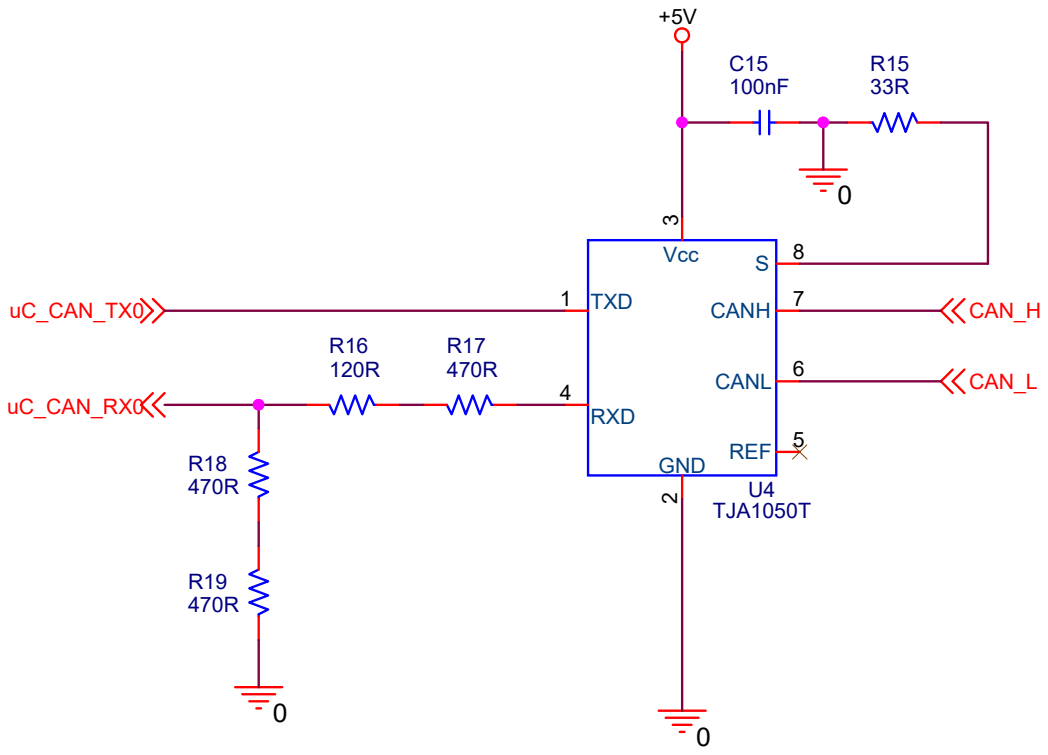
[picture p34: page 11]
uC_CAN_RX0; uC_CAN_TX0; CAN_H; CAN_L; Title; PCB\23-325-0; CAN BUS CH0; U4 TJA1050T; TXD; RXD; GND; 8 S Vcc; 7 CANH; 6 CANL; 5 REF

0

0

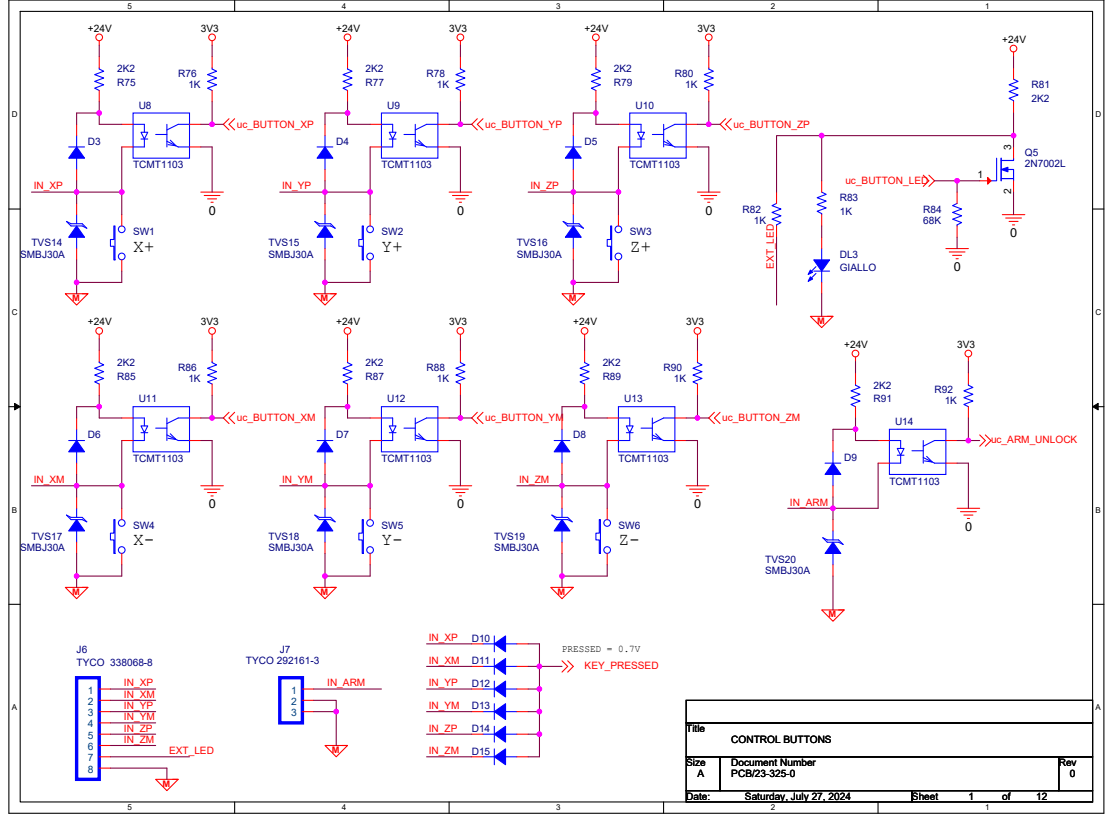
[picture p35: page 12]
