marcorispoli/PCB325/ESECUTIVI/PF23-325-0 .pdf

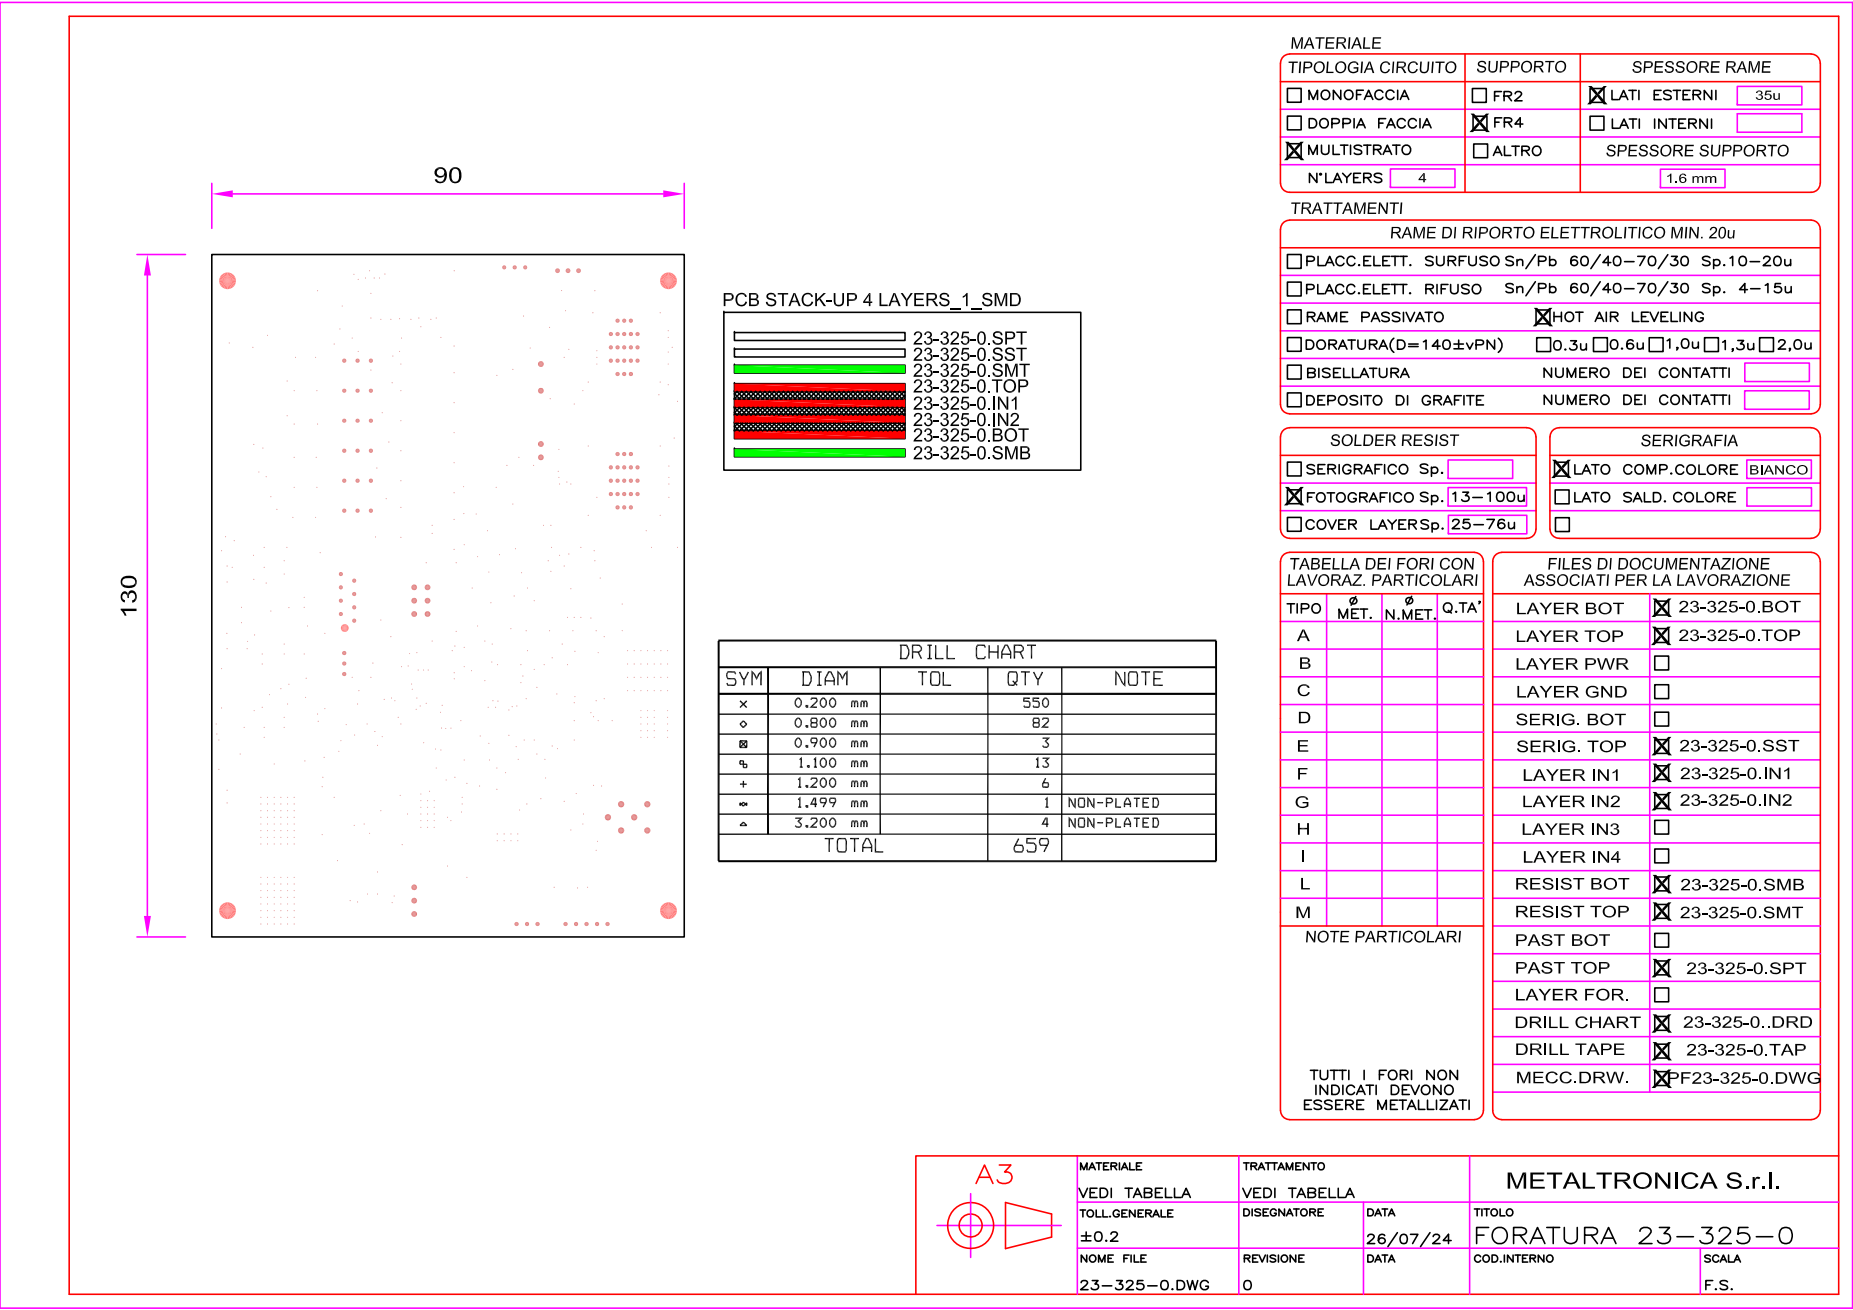
[picture p36: page 1]
