marcorispoli/PCB325/ESECUTIVI/PM23-325-0.pdf

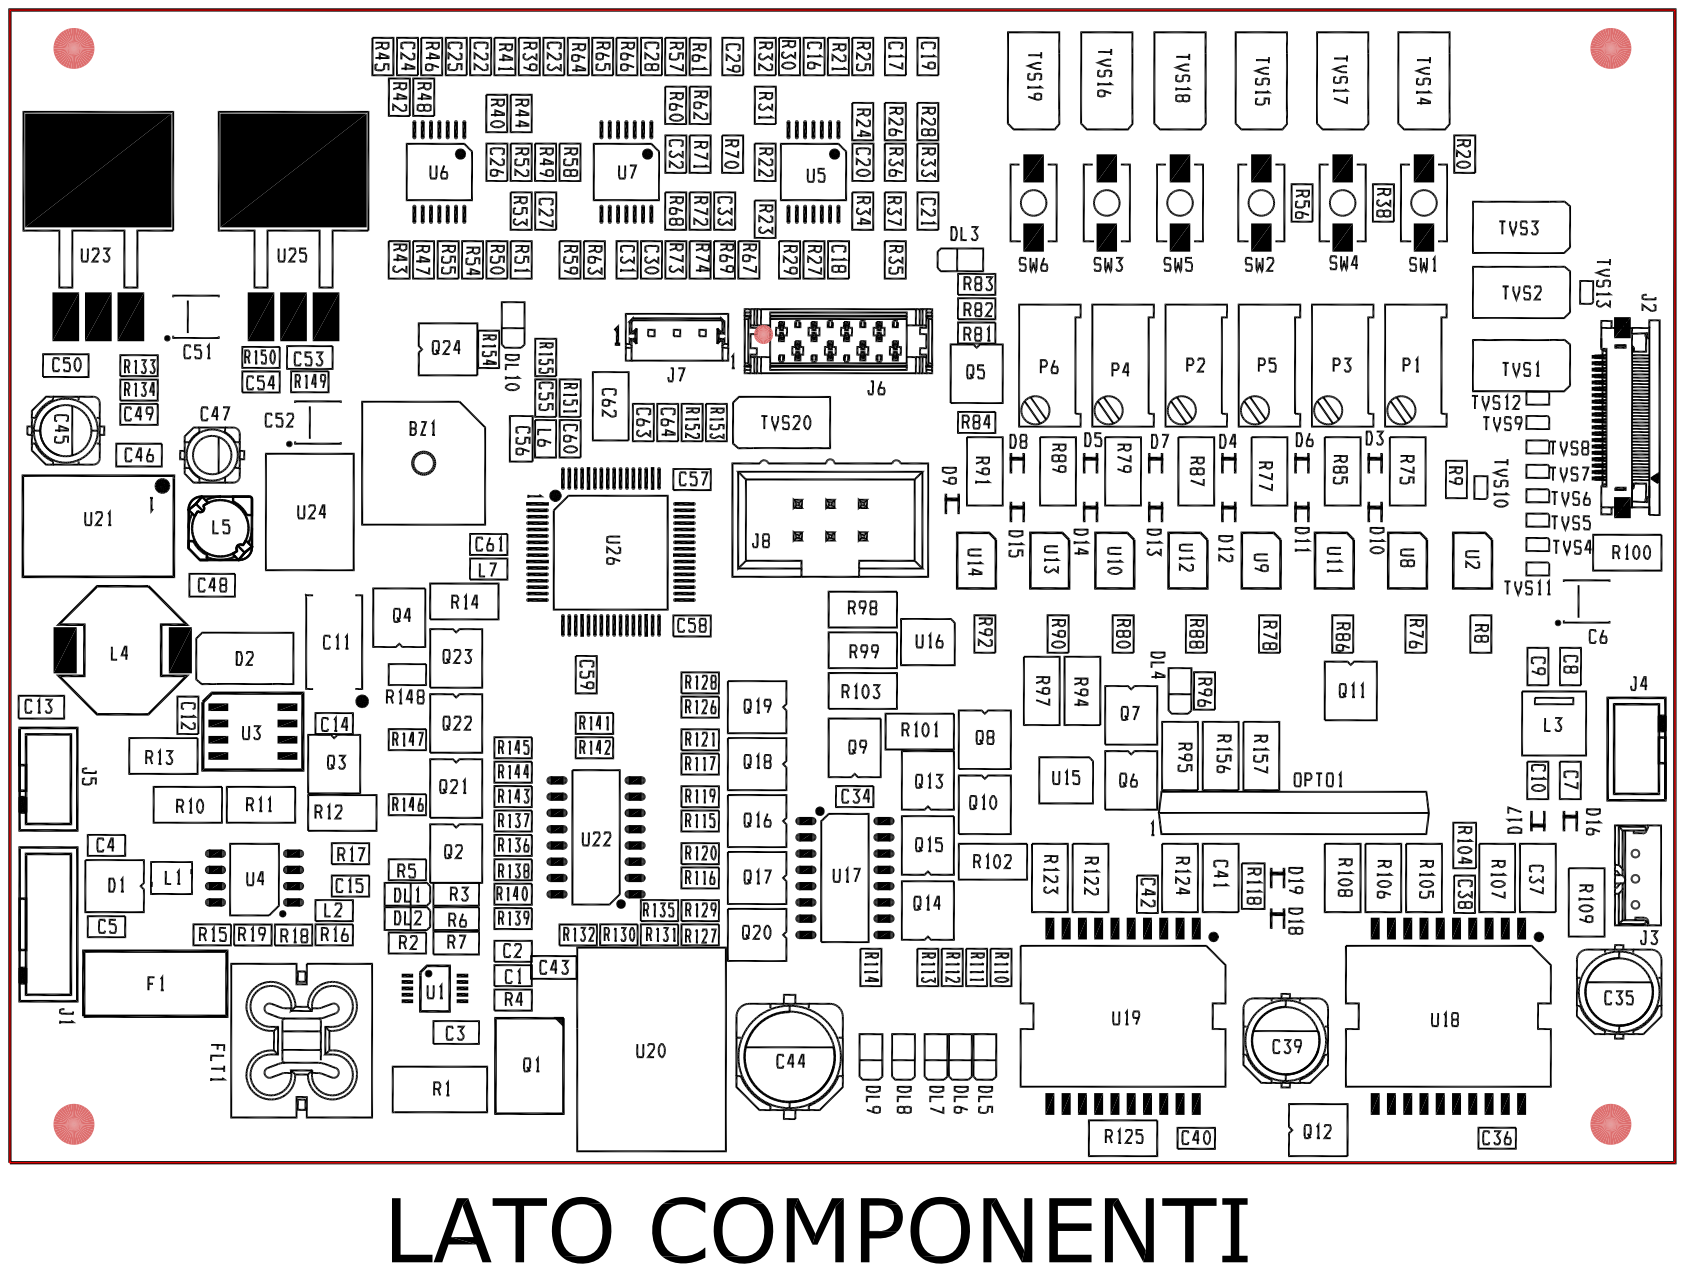
[picture p37: page 1]
