marcorispoli/PCB325/LAYOUT/A0724-001-A - PCB-23-325-0 - SCHEDA CONTROLLER BIOPSIA LATERALE 1.pdf

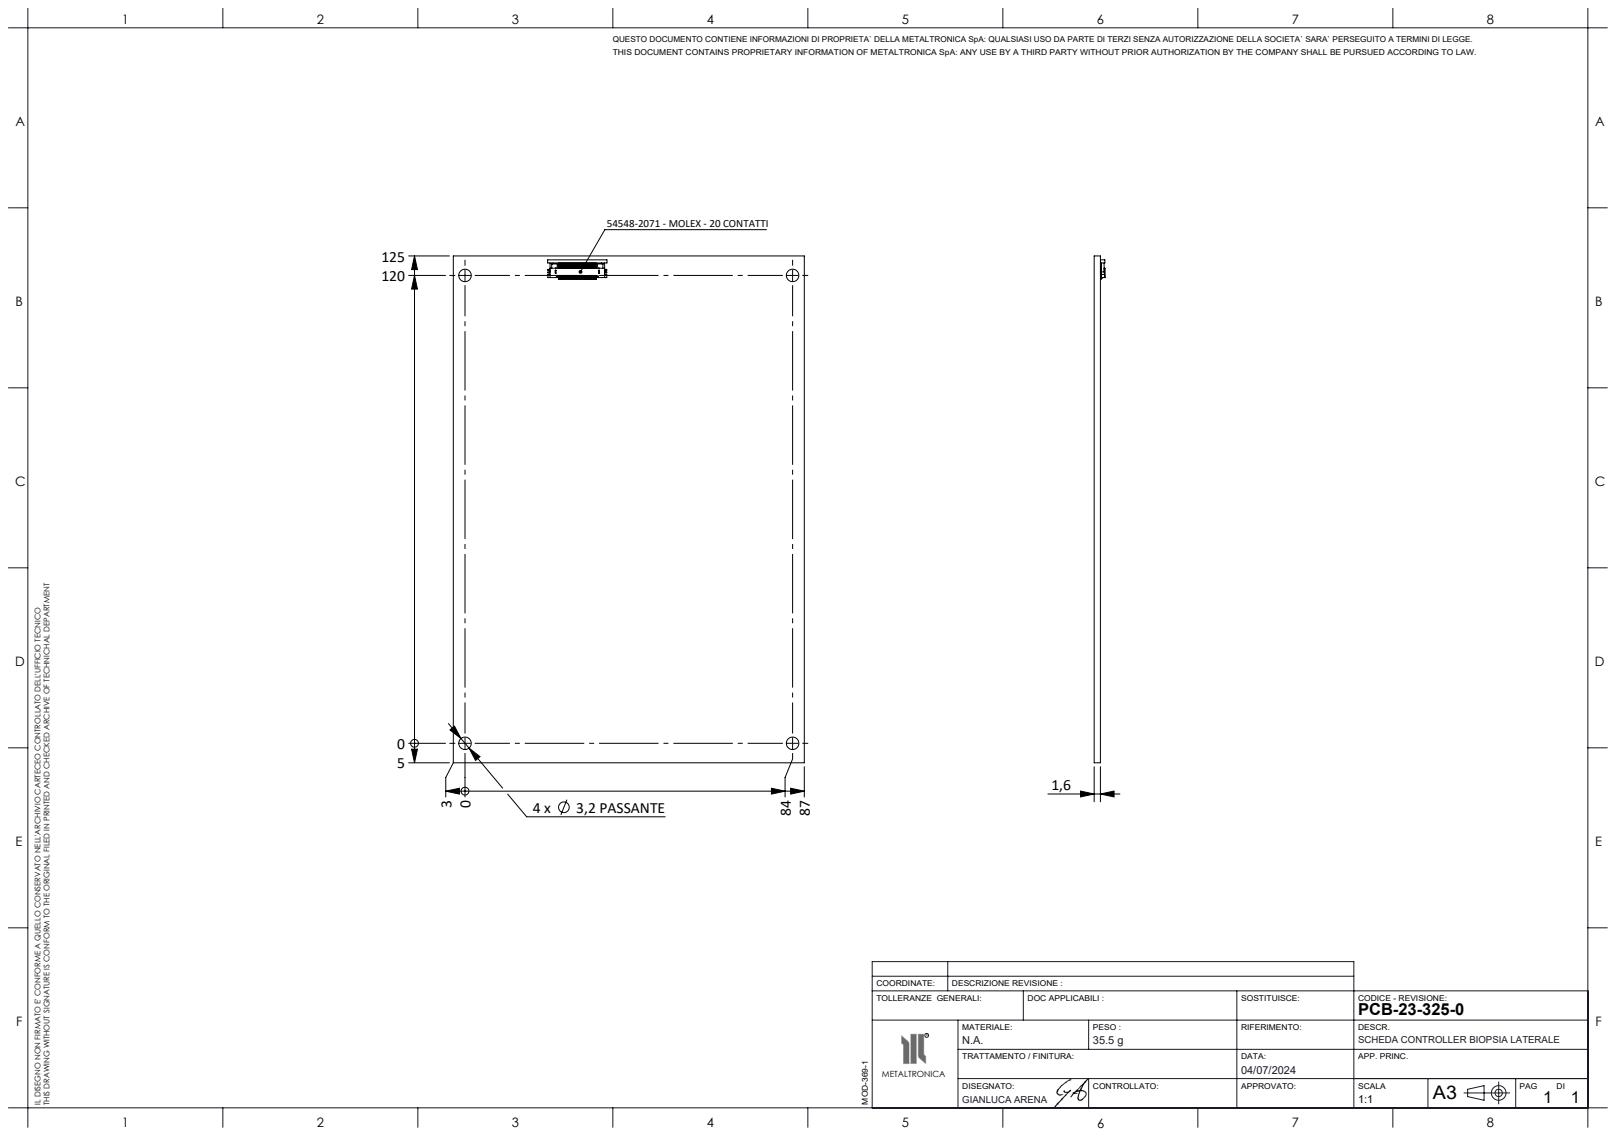
[picture p38: page 1]
TOLLERANZE GENERALI:; CODICE - REVISIONE:; PESO :; RIFERIMENTO:; DESCR.; COORDINATE:; DESCRIZIONE REVISIONE :; DOC APPLICABILI :; TRATTAMENTO / FINITURA:; 3,2 PASSANTE; 54548-2071 - MOLEX - 20 CONTATTI; GIANLUCA ARENA

QUESTO DOCUMENTO CONTIENE INFORMAZIONI DI PROPRIETA` DELLA METALTRONICA SpA: QUALSIASI USO DA PARTE DI TERZI SENZA AUTORIZZAZIONE DELLA SOCIETA` SARA` PERSEGUITO A TERMINI DI LEGGE.
THIS DOCUMENT CONTAINS PROPRIETARY INFORMATION OF METALTRONICA SpA: ANY USE BY A THIRD PARTY WITHOUT PRIOR AUTHORIZATION BY THE COMPANY SHALL BE PURSUED ACCORDING TO LAW.

THIS DRAWING WITHOUT SIGNATURE IS CONFORM TO THE ORIGINAL FILED IN PRINTED AND CHECKED ARCHIVE OF TECHNICHAL DEPARTMENT

IL DISEGNO NON FIRMATO E' CONFORME A QUELLO CONSERVATO NELL'ARCHIVIO CARTECEO CONTROLLATO DELL'UFFICIO TECNICO

SCHEDA CONTROLLER BIOPSIA LATERALE
APP. PRINC.
