marcorispoli/PCB325/(list of files, drawings)

Other design files:
ORCAD/23-325-0.DSN
ORCAD/23-325-0.opj
