marcorispoli/PCB325/(commit log)

2024-07-31 Project created with the first release
    [23-325-0.DSN, 23-325-0.dwg, 23-325-0.opj, A0724-001-A - PCB-23-325-0 - SCHEDA CONTROLLER BIOPSIA LATERALE 1.DXF, LP23-325-0.xlsx, PF23-325-0.dwg, PM23-325-0.dwg]
2024-10-16 Verifica circuito
    [23-325-0.DSN, 23-325-0.opj, LP23-325-0.xlsx]
2024-10-17 avanzamento in note di progetto e debug scheda
2024-10-18 Ahggiunto note di verifica per driver motori
2024-10-20 Completato TEst Scheda
    [Calcoli.xlsx]
2025-06-19 Aggiunta documentazione a corredo
    [23-325-0.opj]
2026-03-06 Modificata lista parti (e aggiornato schematico) per condensatori C45, C47 e Q1 con footprint non corretto Relaizzata lista parti in revisione 1
    [23-325-0.DSN, 23-325-0.opj, LP23-325-0.xlsx, LP23-325-0_ASSY00_REV01.xlsx]
2026-03-10 Aggiornata nuovamente lista parti senza cambio di revisione: I condensatori dovevano essere in alluminio non Tantalio
    [LP23-325-0_ASSY00_REV01.xlsx]
